Justin-Vuong/2024_WSB/README.md

WSB_Front
WSB_Back
