Justin-Vuong/2024_WSB/2024_WSB.pdf

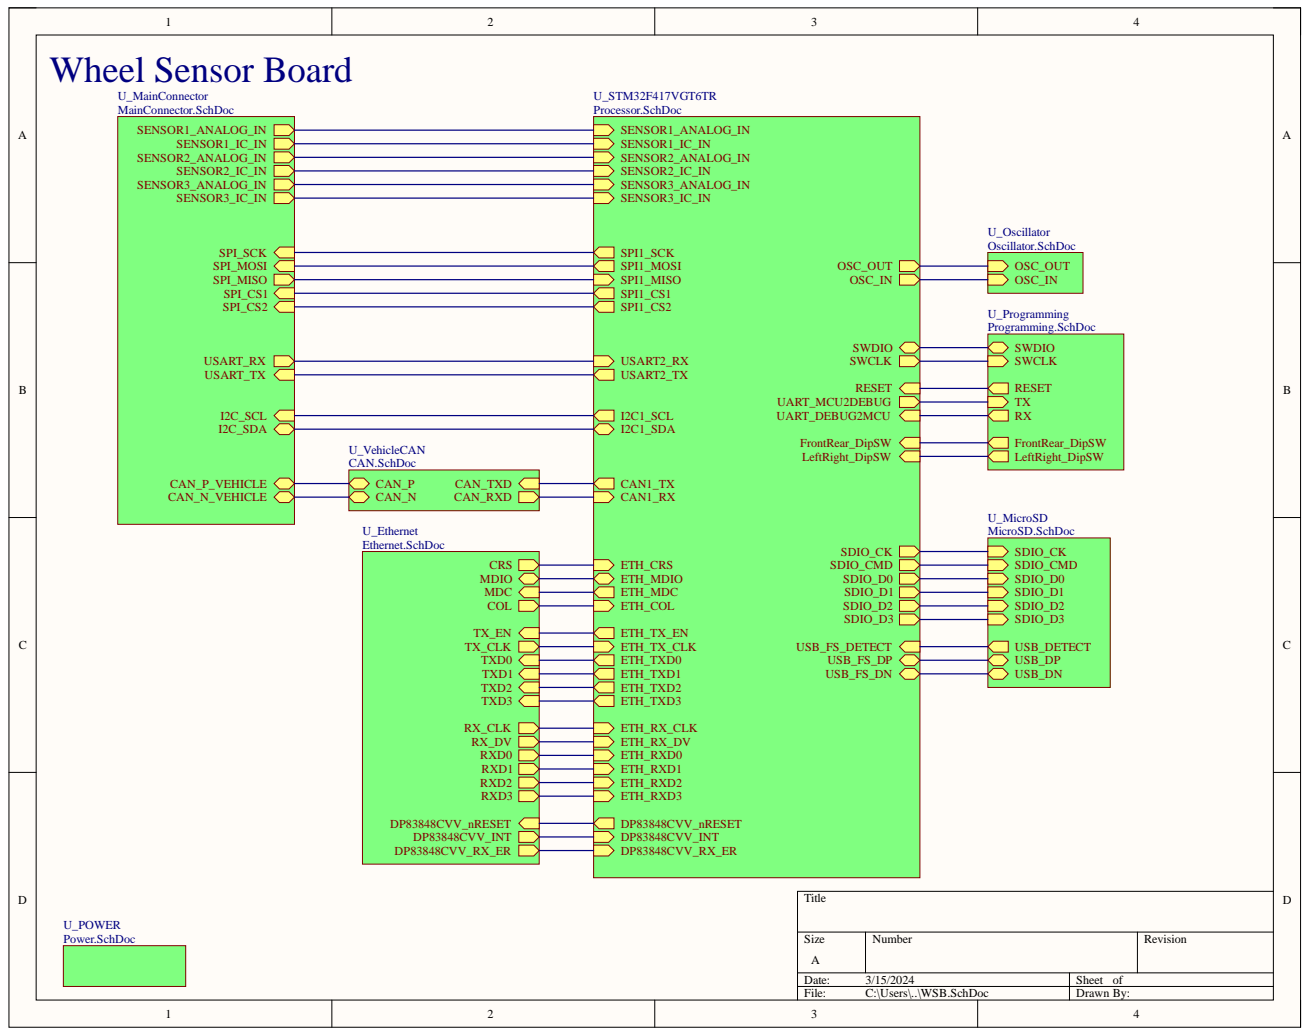
[picture p1: page 1]

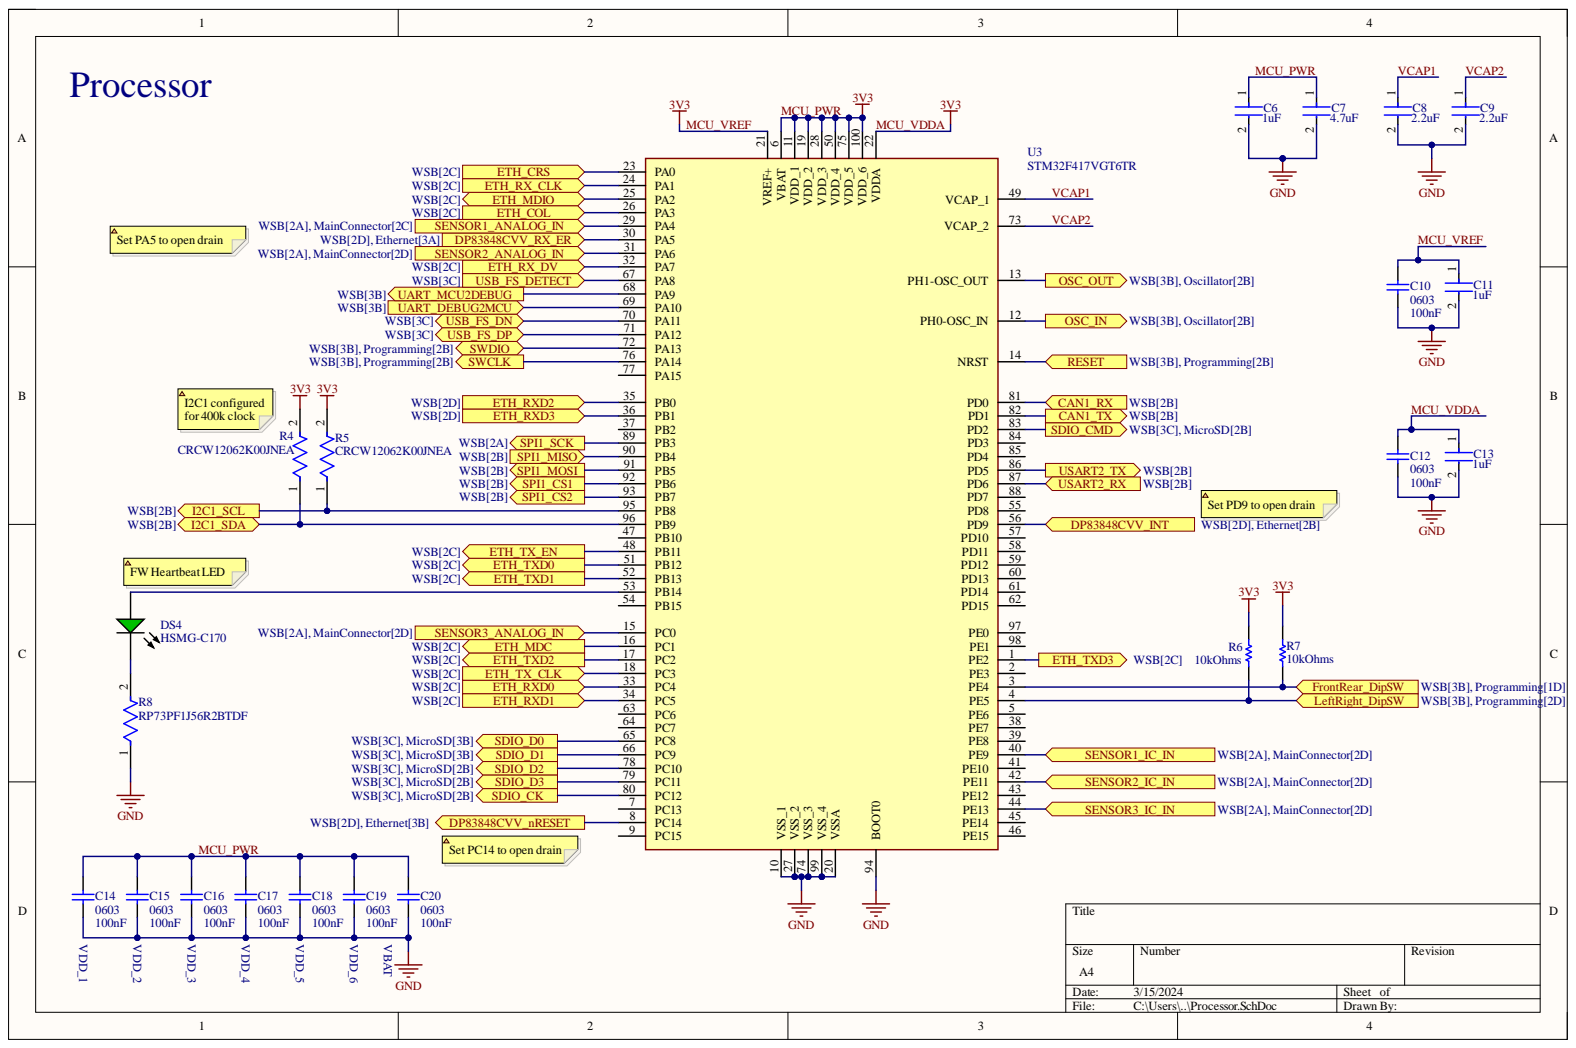
[picture p2: page 2]

Set PA5 to open drain

Set PD9 to open drain

Set PC14 to open drain

Size A4 | Number | Revision

Date: 3/15/2024 | Sheet of
File: C:\Users\..\Processor.SchDoc | Drawn By:

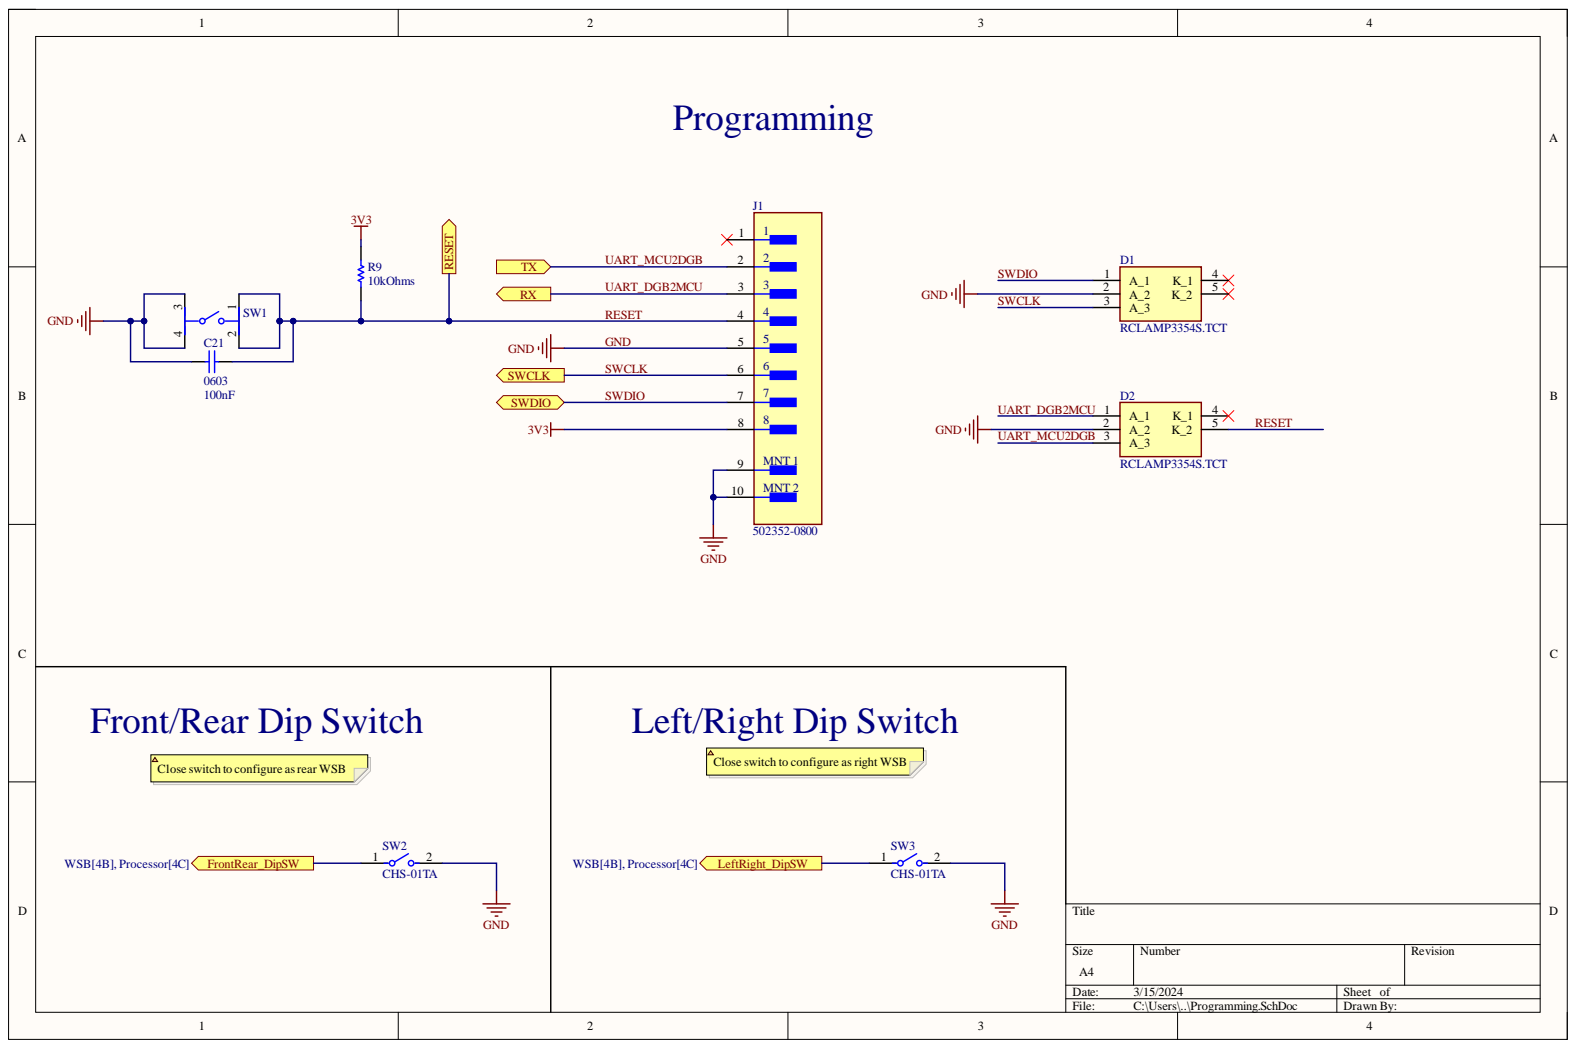
[picture p3: page 3]

Front/Rear Dip Switch Close switch to configure as rear WSB WSB[4B], Processor[4C] FrontRear_DipSW 1 2 SW2 | Left/Right Dip Switch Close switch to configure as right WSB 1 2 SW3

Size A4 | Number | Revision

Date: 3/15/2024 | Sheet of
File: C:\Users\..\Programming.SchDoc | Drawn By:

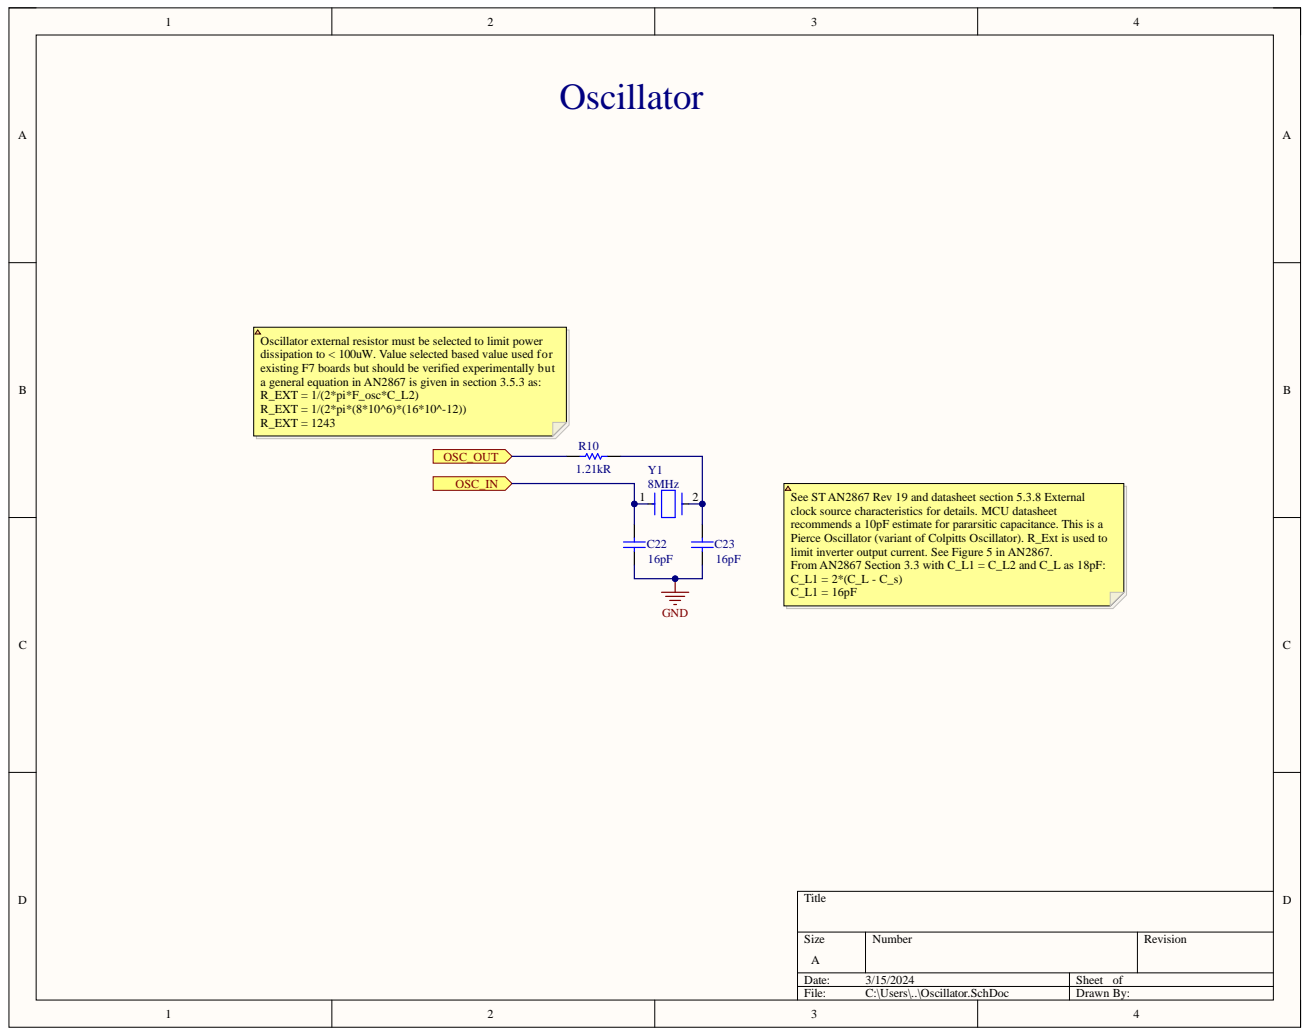
[picture p4: page 4]

Oscillator external resistor must be selected to limit power
dissipation to < 100uW. Value selected based value used for
existing F7 boards but should be verified experimentally but
a general equation in AN2867 is given in section 3.5.3 as:
R_EXT = 1/(2*pi*F_osc*C_L2)
R_EXT = 1/(2*pi*(8*10^6)*(16*10^-12))
R_EXT = 1243

See ST AN2867 Rev 19 and datasheet section 5.3.8 External
clock source characteristics for details. MCU datasheet
recommends a 10pF estimate for pararsitic capacitance. This is a
Pierce Oscillator (variant of Colpitts Oscillator). R_Ext is used to
limit inverter output current. See Figure 5 in AN2867.
From AN2867 Section 3.3 with C_L1 = C_L2 and C_L as 18pF:

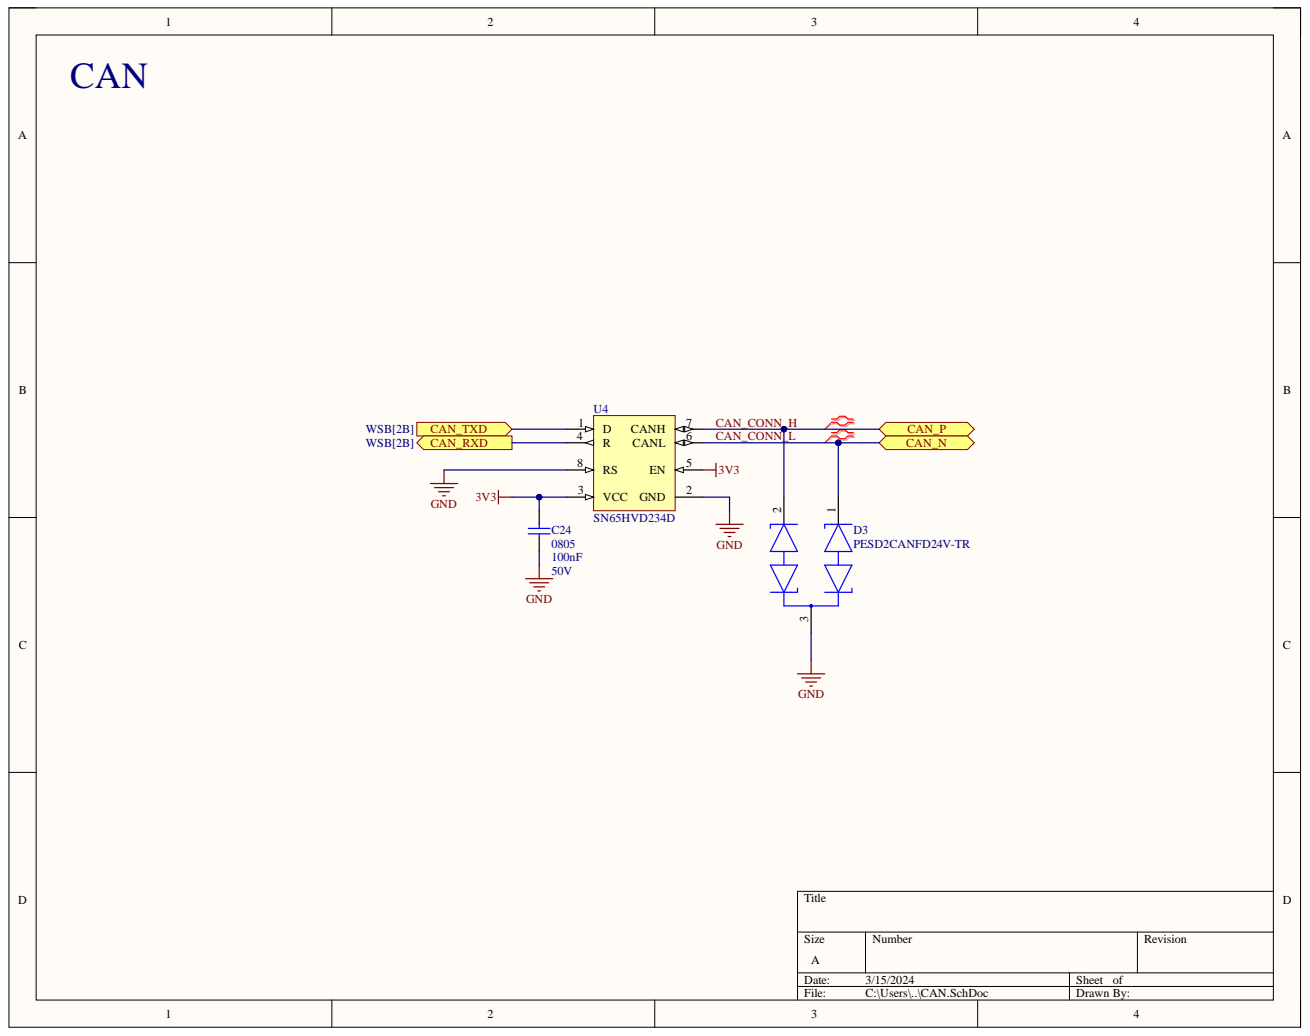
[picture p5: page 5]

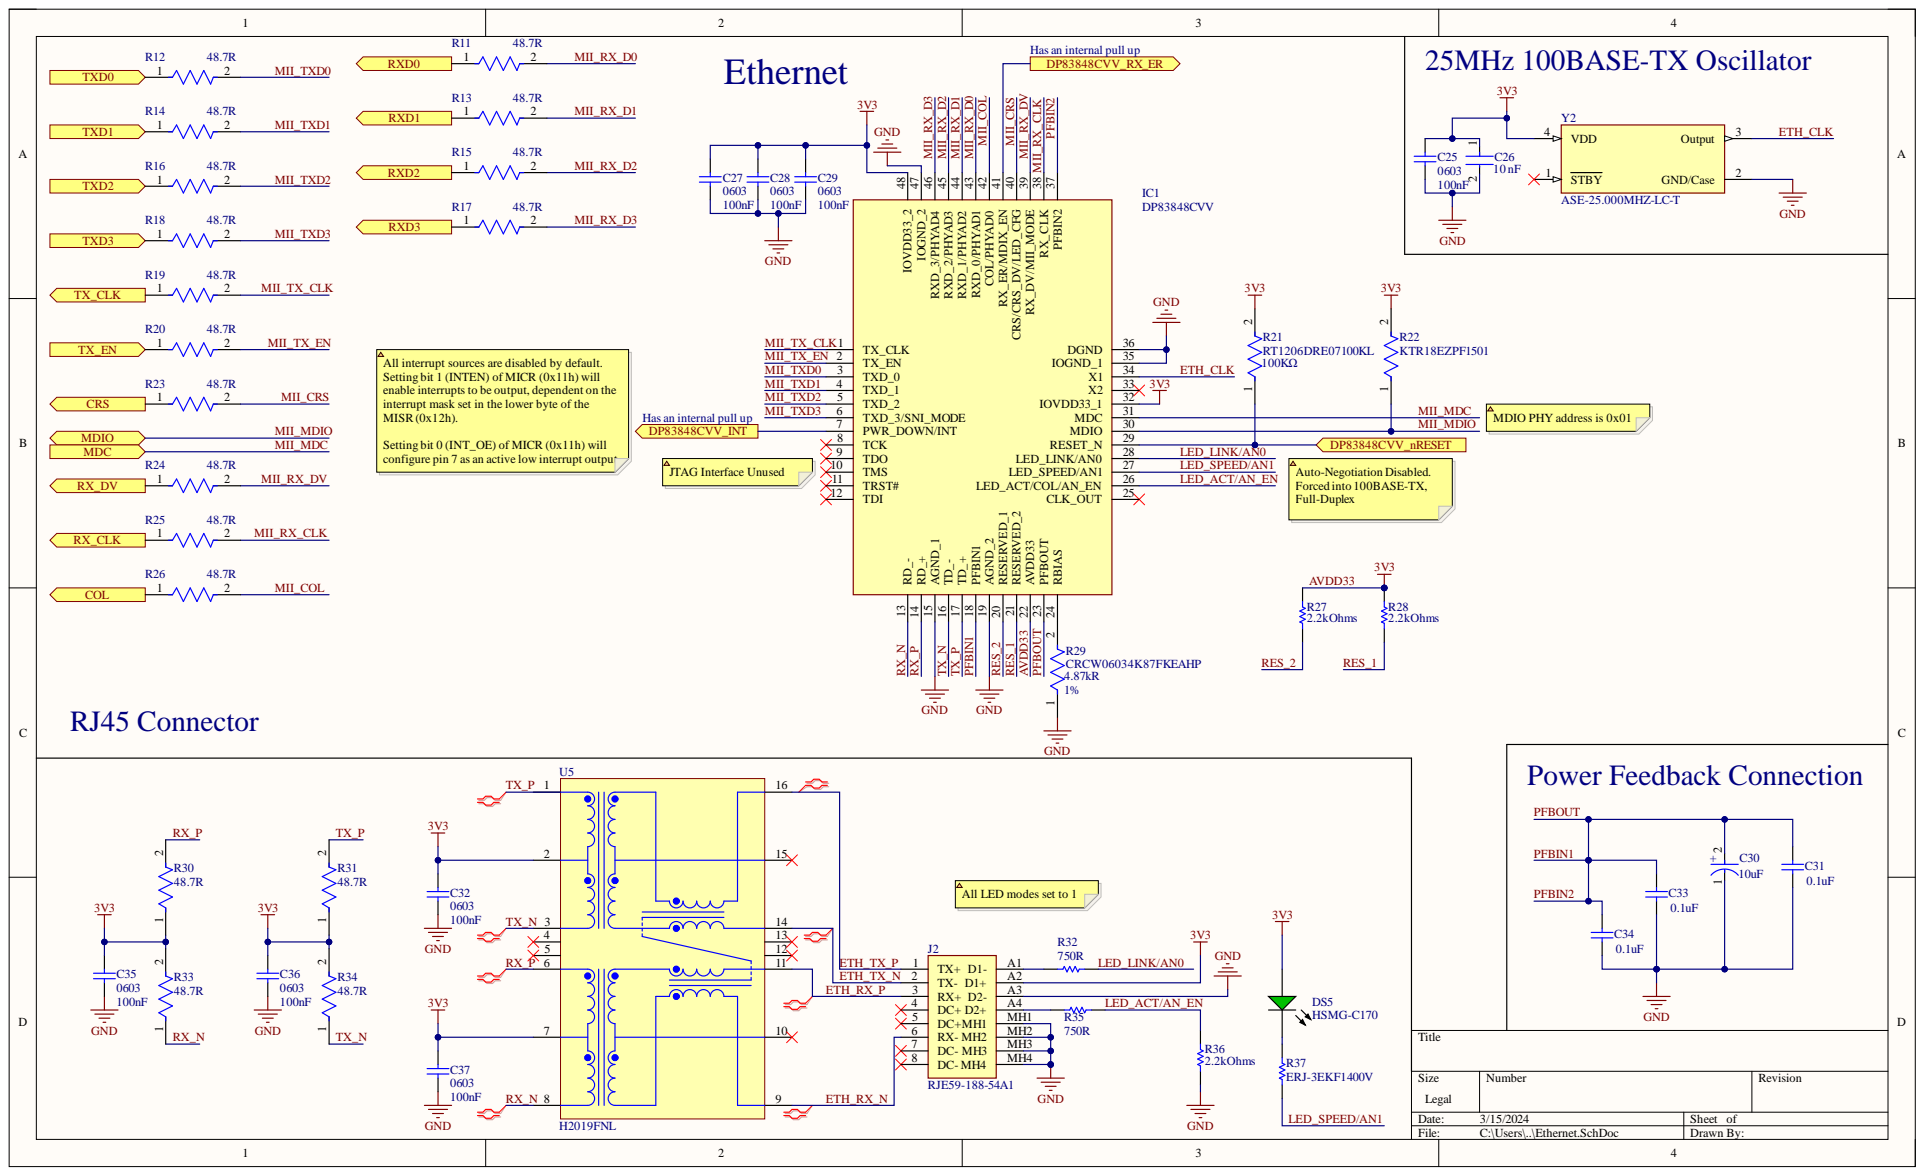
[picture p6: page 6]

Has an internal pull up | 25MHz 100BASE-TX Oscillator 3V3

All interrupt sources are disabled by default.
Setting bit 1 (INTEN) of MICR (0x11h) will
enable interrupts to be output, dependent on the
interrupt mask set in the lower byte of the
MISR (0x12h).

Has an internal pull up
DP83848CVV_INT

MDIO PHY address is 0x01

Setting bit 0 (INT_OE) of MICR (0x11h) will
configure pin 7 as an active low interrupt output

15 | ETH_TX_N

PFBIN1

All LED modes set to 1

ETH_RX_P | RX+ 3

DC+ 4 | LED_ACT/AN_EN

Size Legal | Number | Revision

Date: 3/15/2024 | Sheet of
File: C:\Users\..\Ethernet.SchDoc | Drawn By:

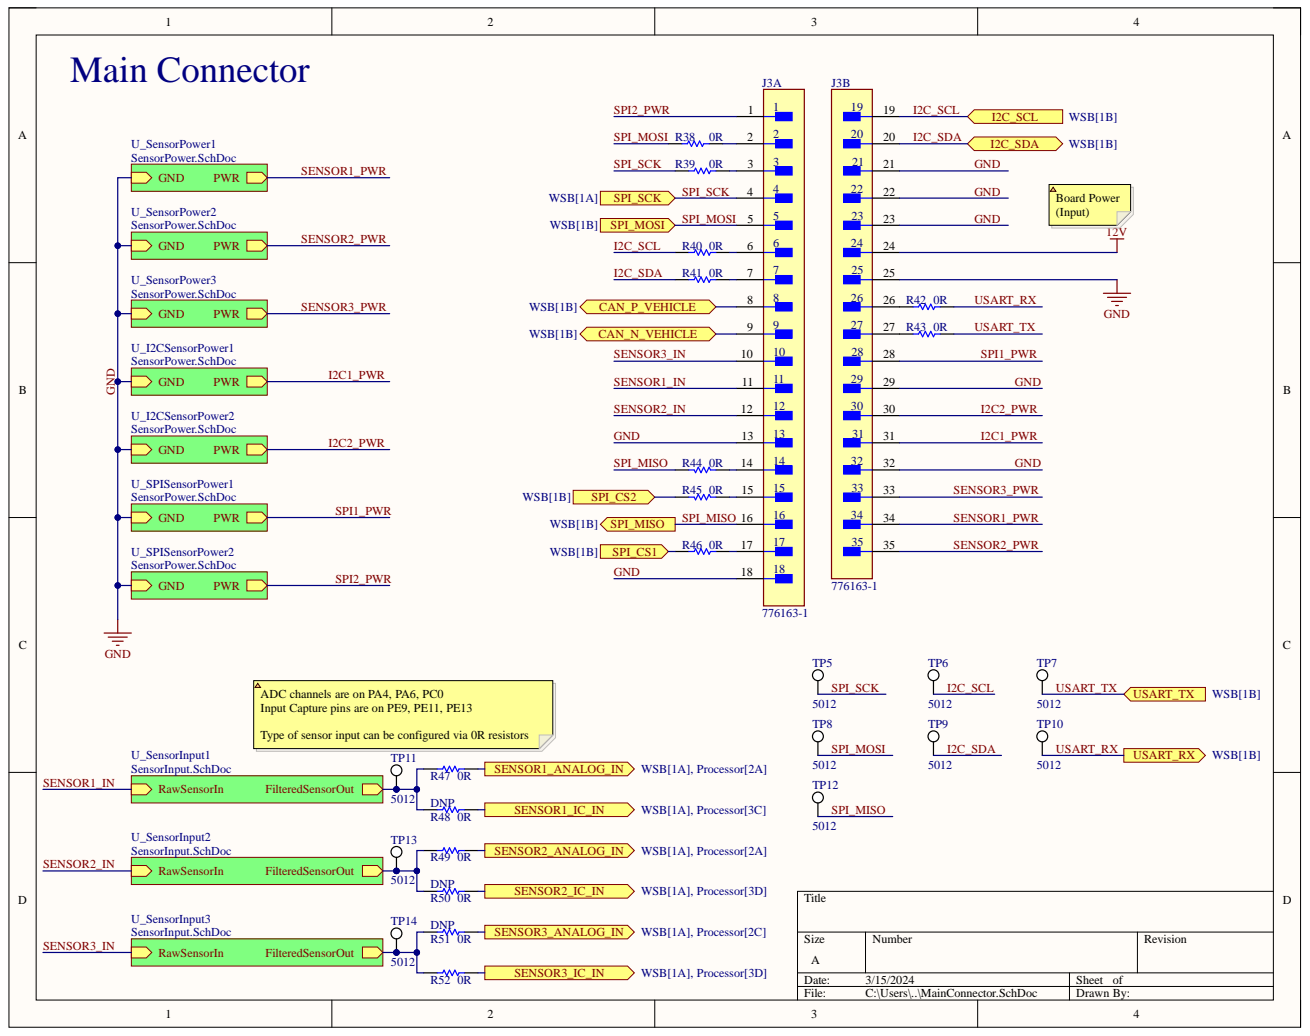
[picture p7: page 7]

ADC channels are on PA4, PA6, PC0
Input Capture pins are on PE9, PE11, PE13

Type of sensor input can be configured via 0R resistors

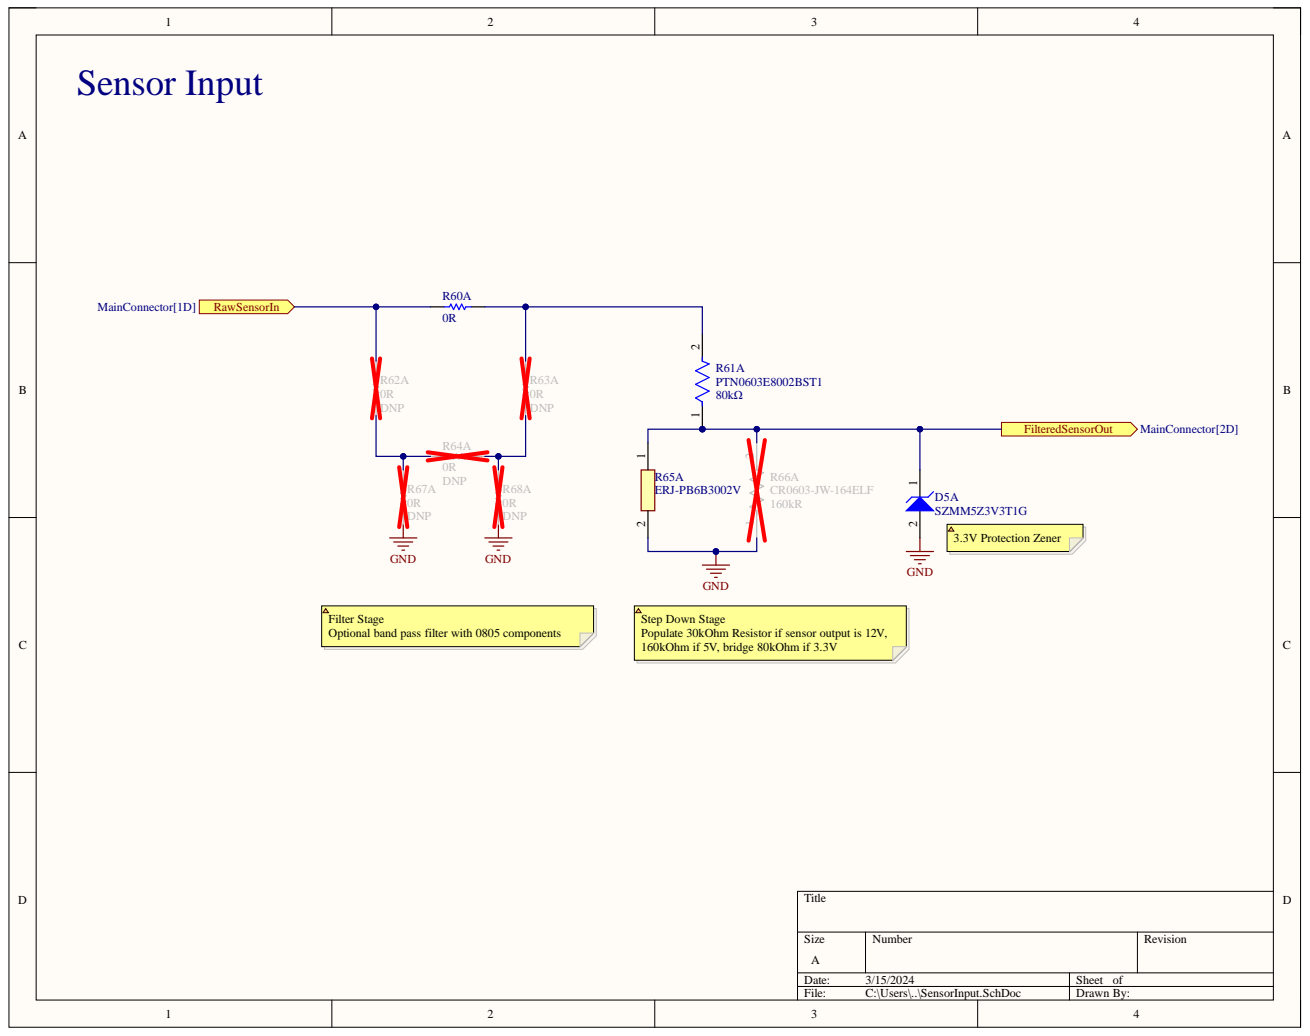
[picture p8: page 8]

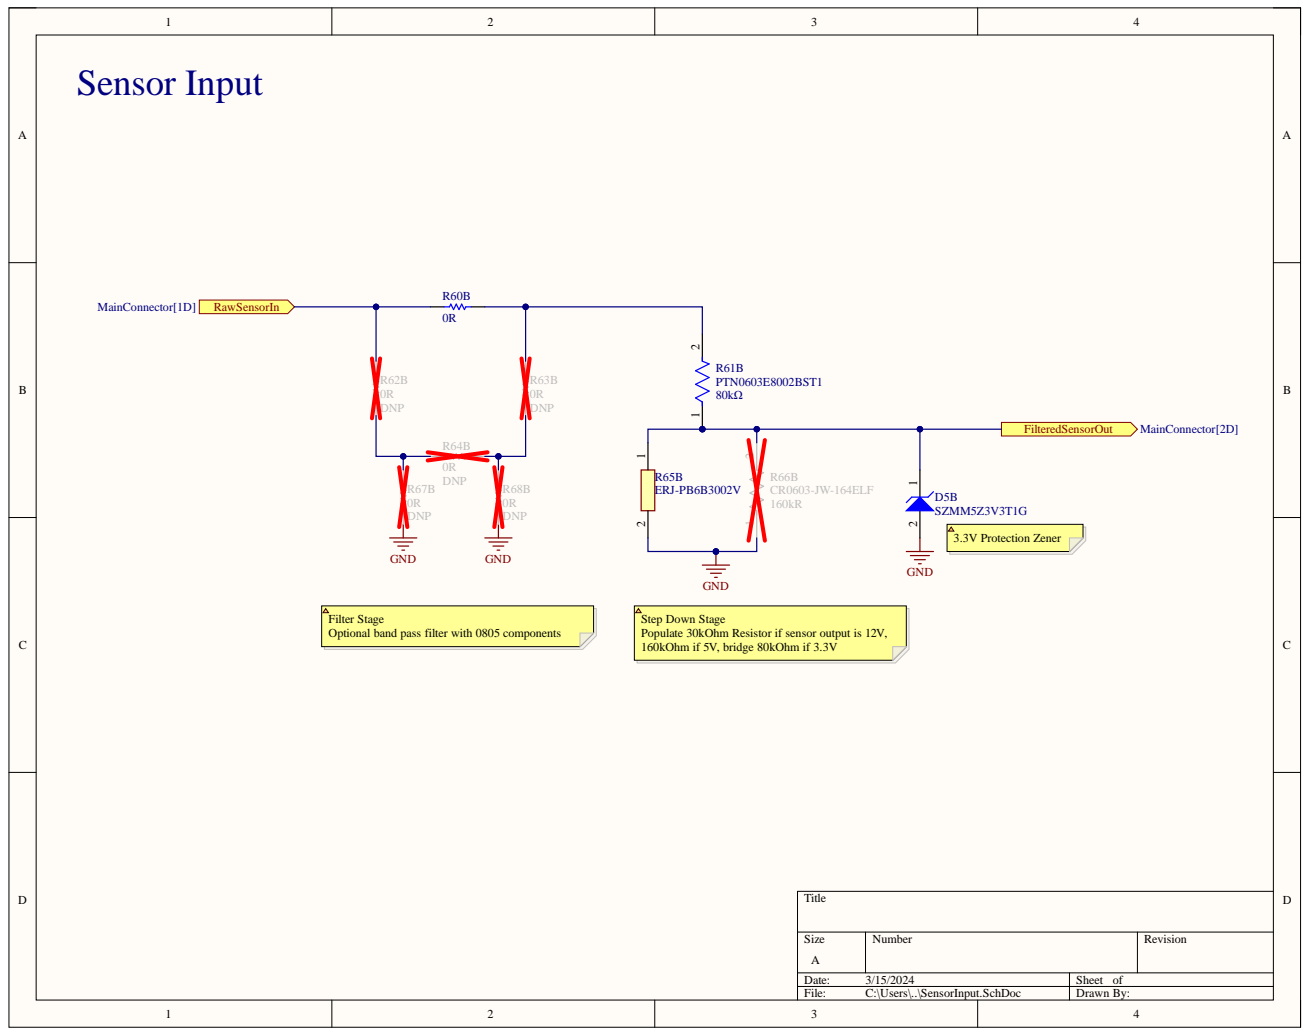
[picture p9: page 9]

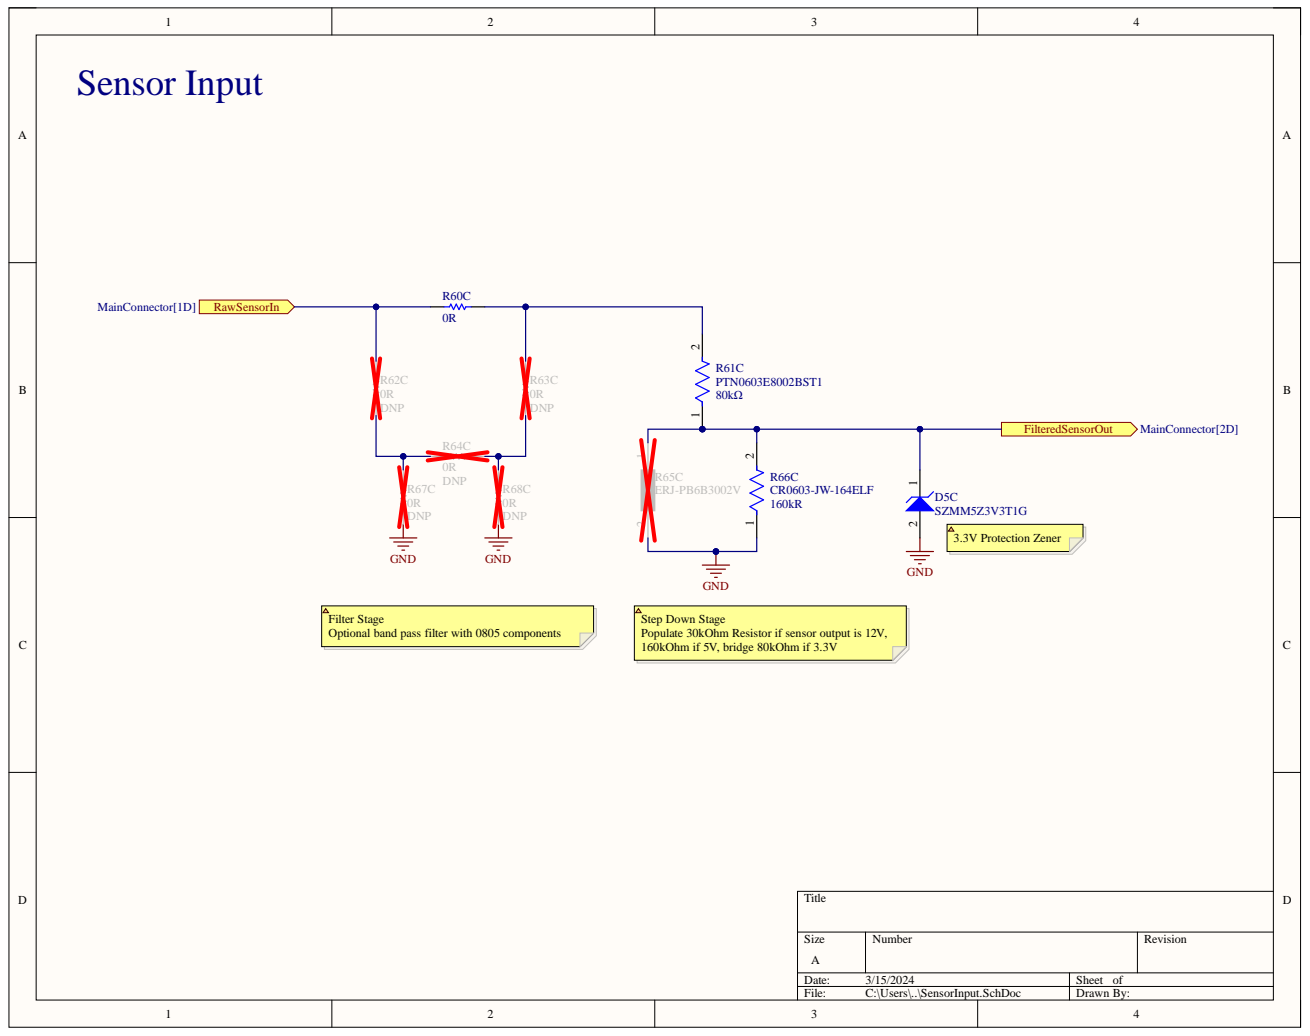
[picture p10: page 10]

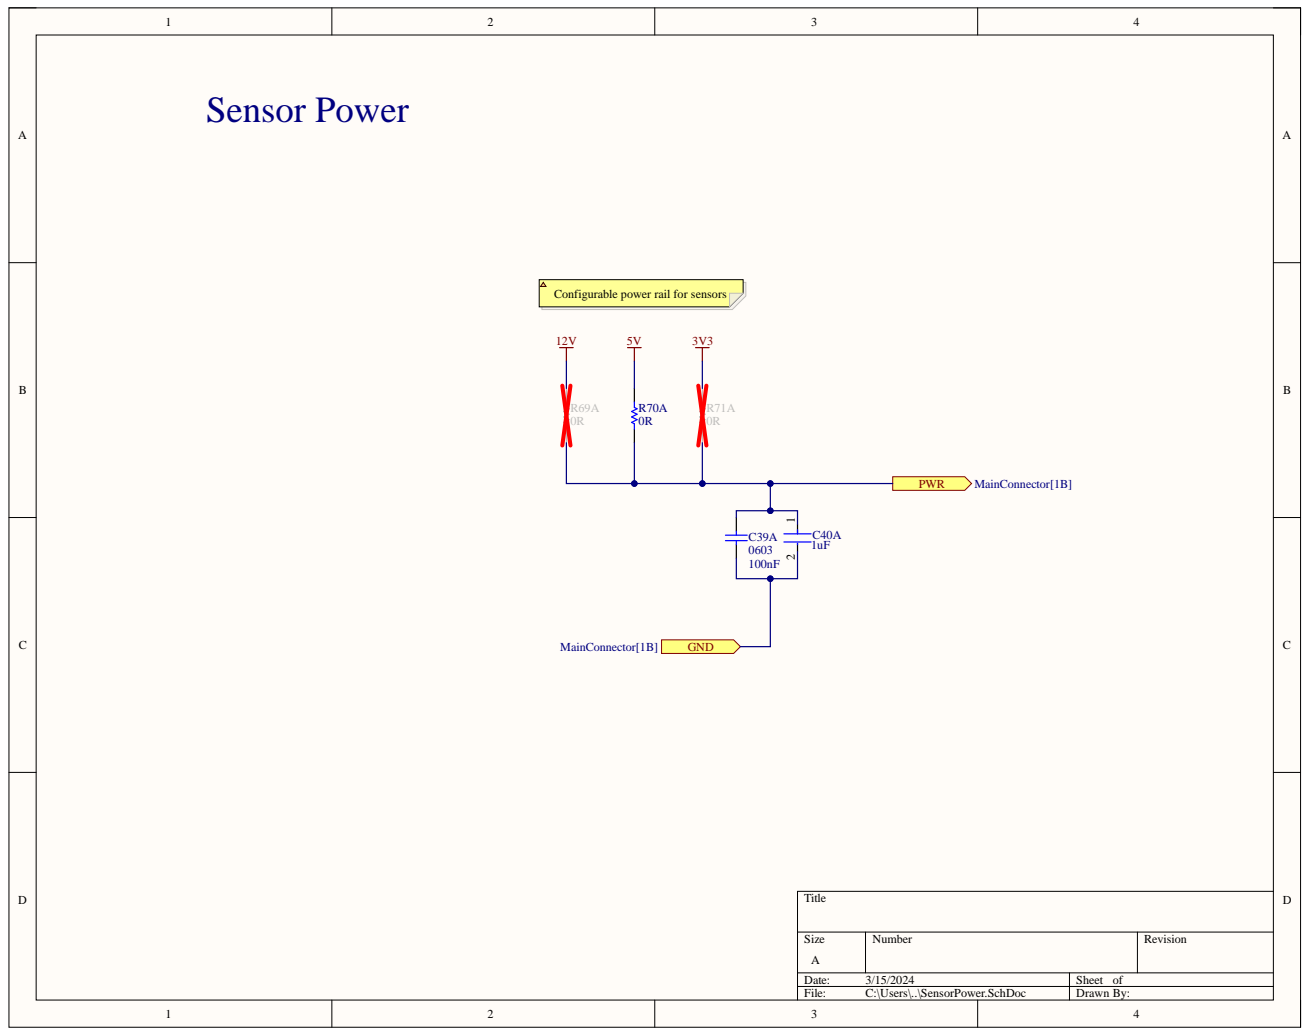
[picture p11: page 11]

Configurable power rail for sensors

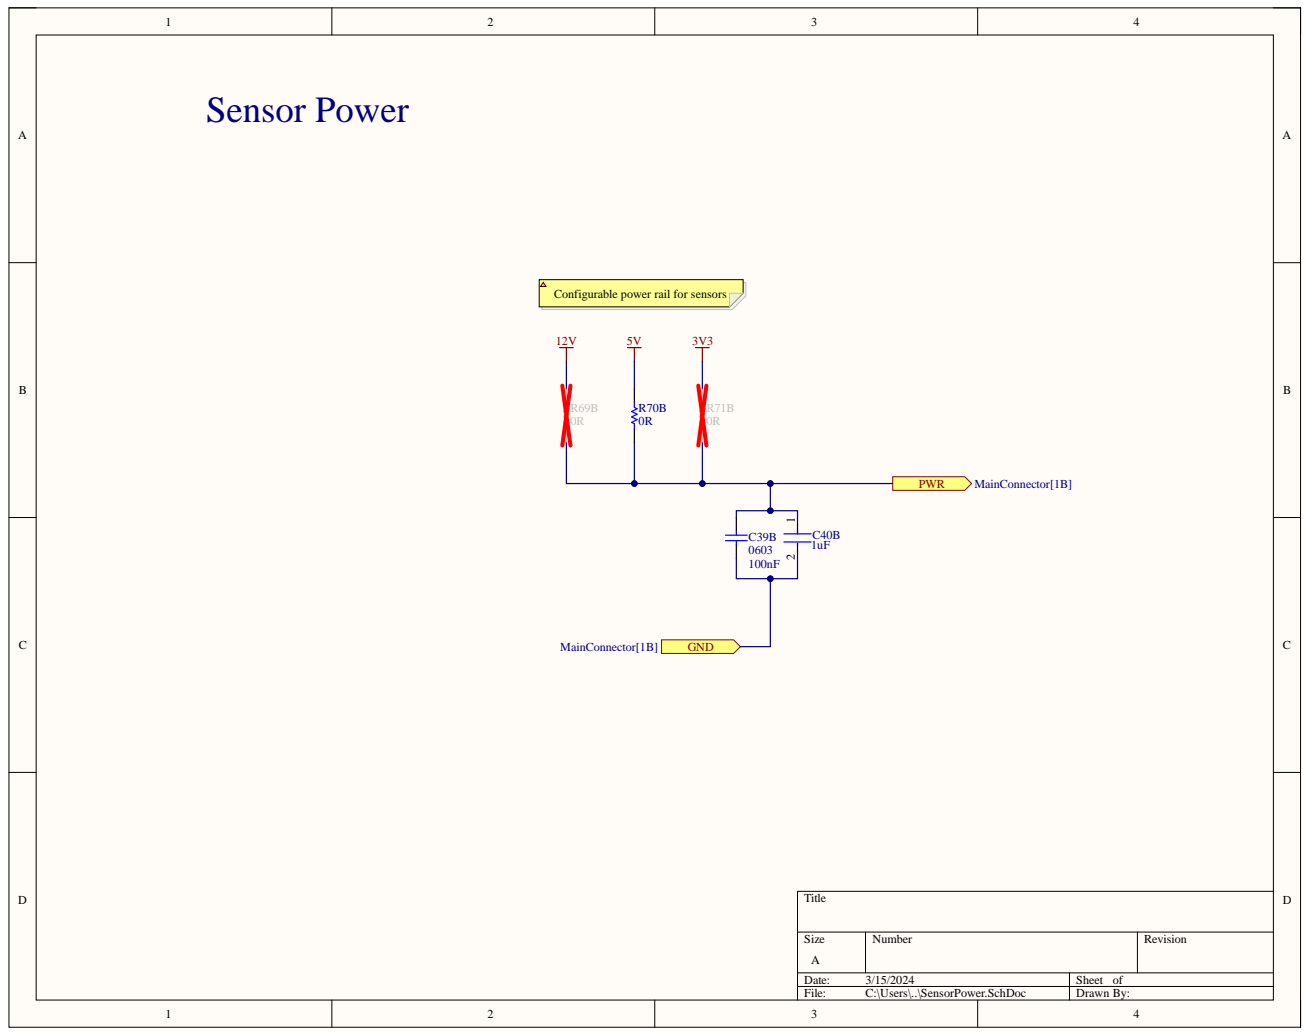
[picture p12: page 12]

Configurable power rail for sensors

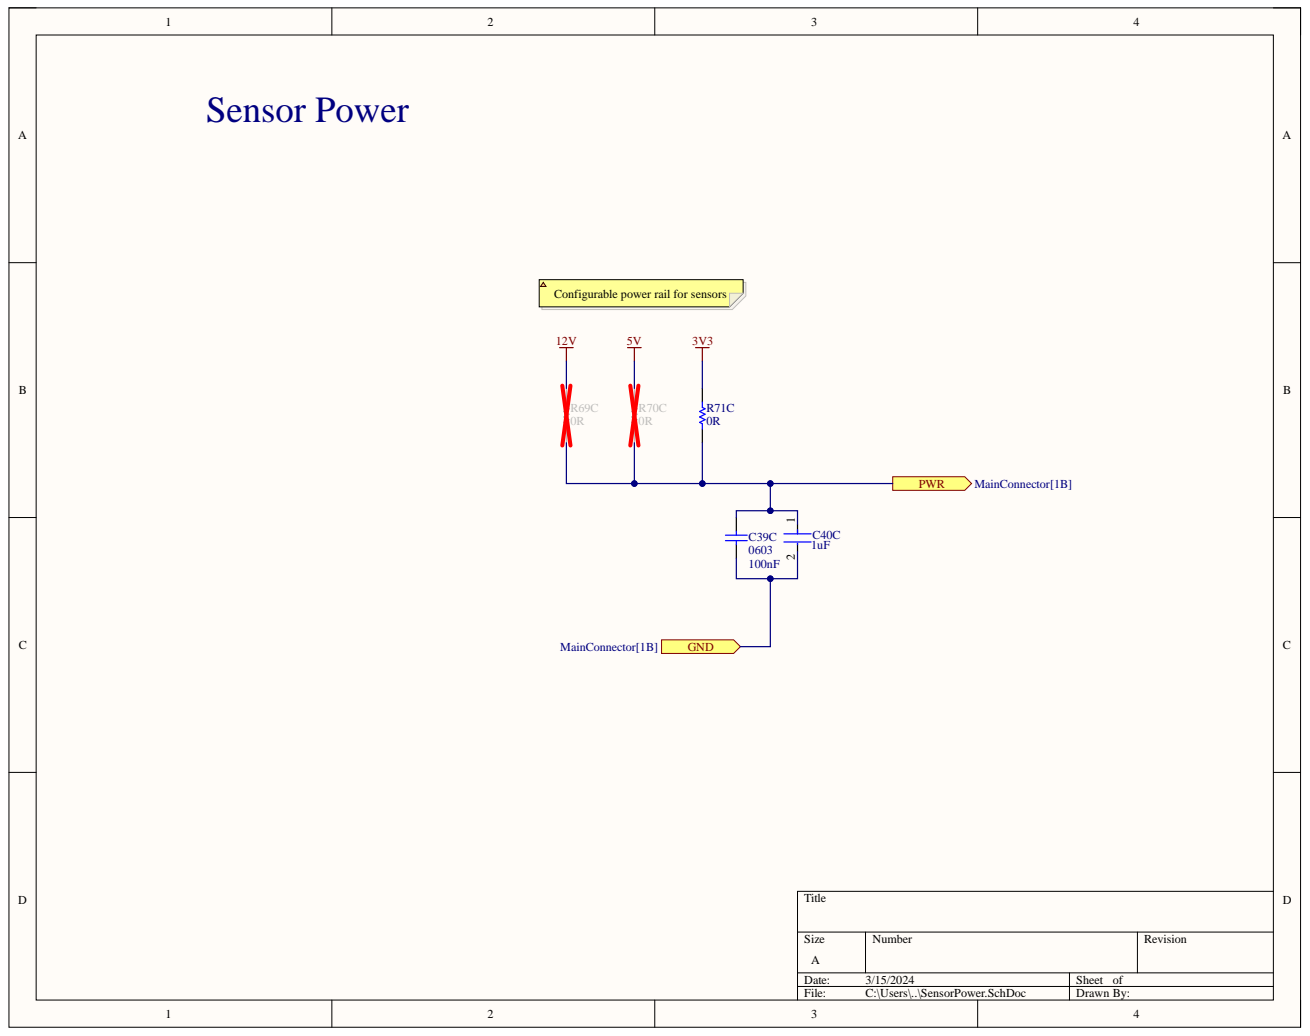
[picture p13: page 13]

Configurable power rail for sensors

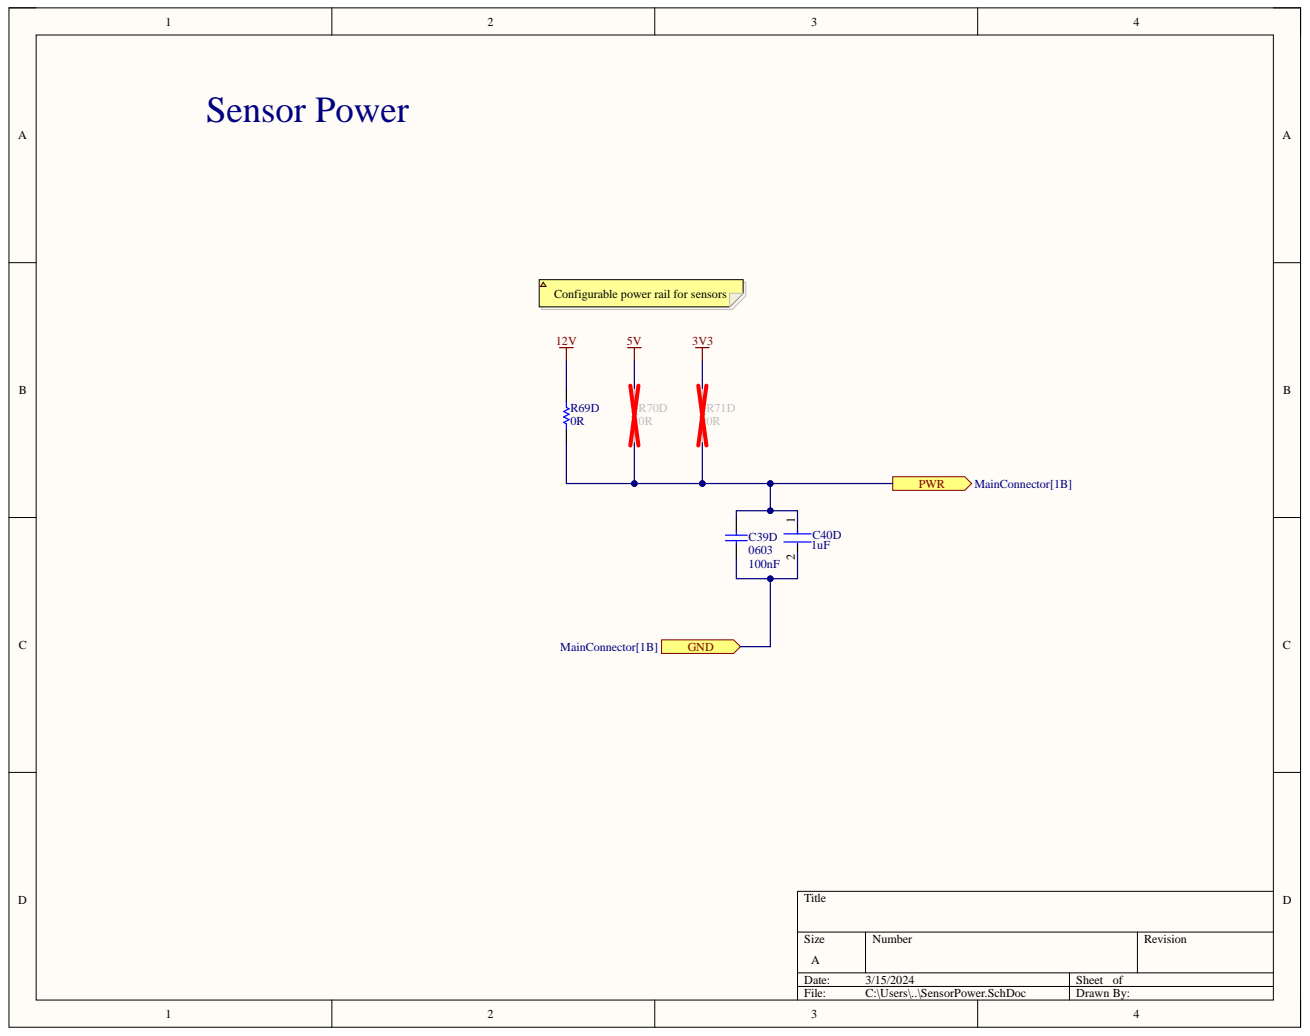
[picture p14: page 14]

Configurable power rail for sensors

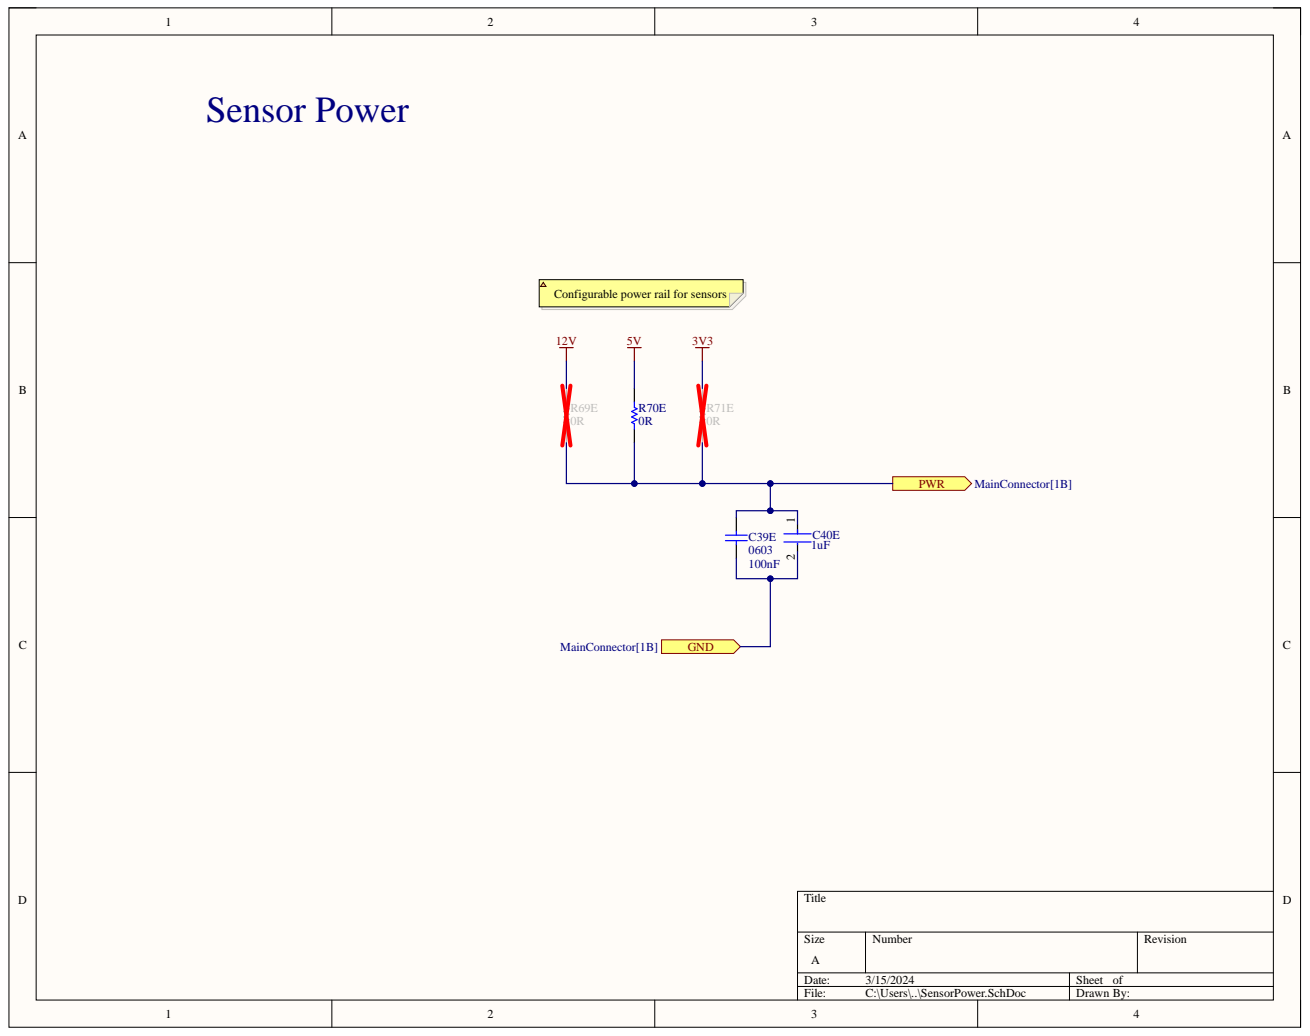
[picture p15: page 15]

Configurable power rail for sensors

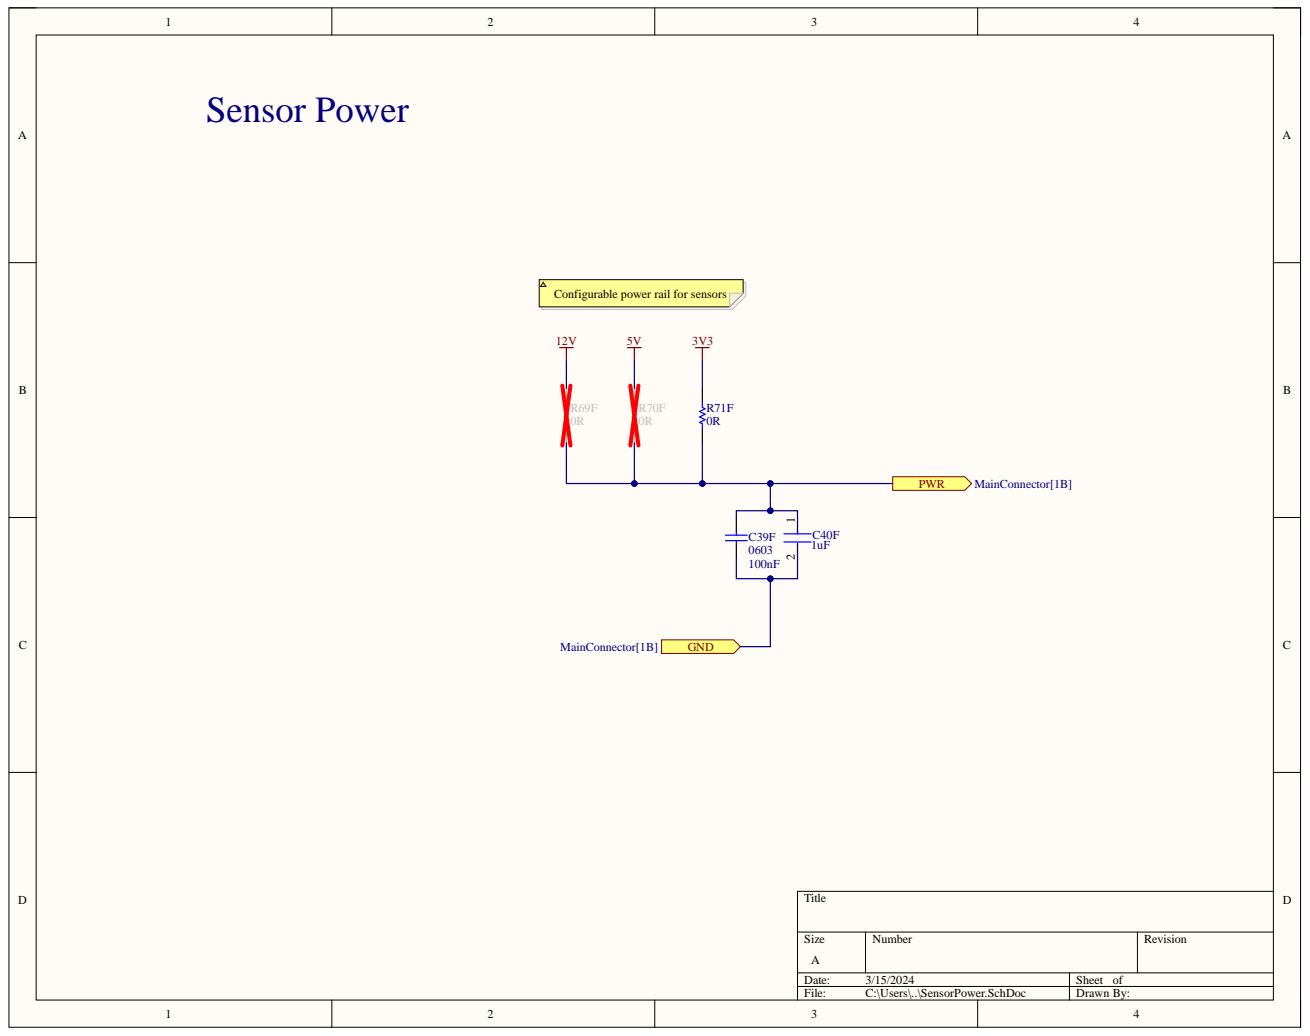
[picture p16: page 16]

Configurable power rail for sensors

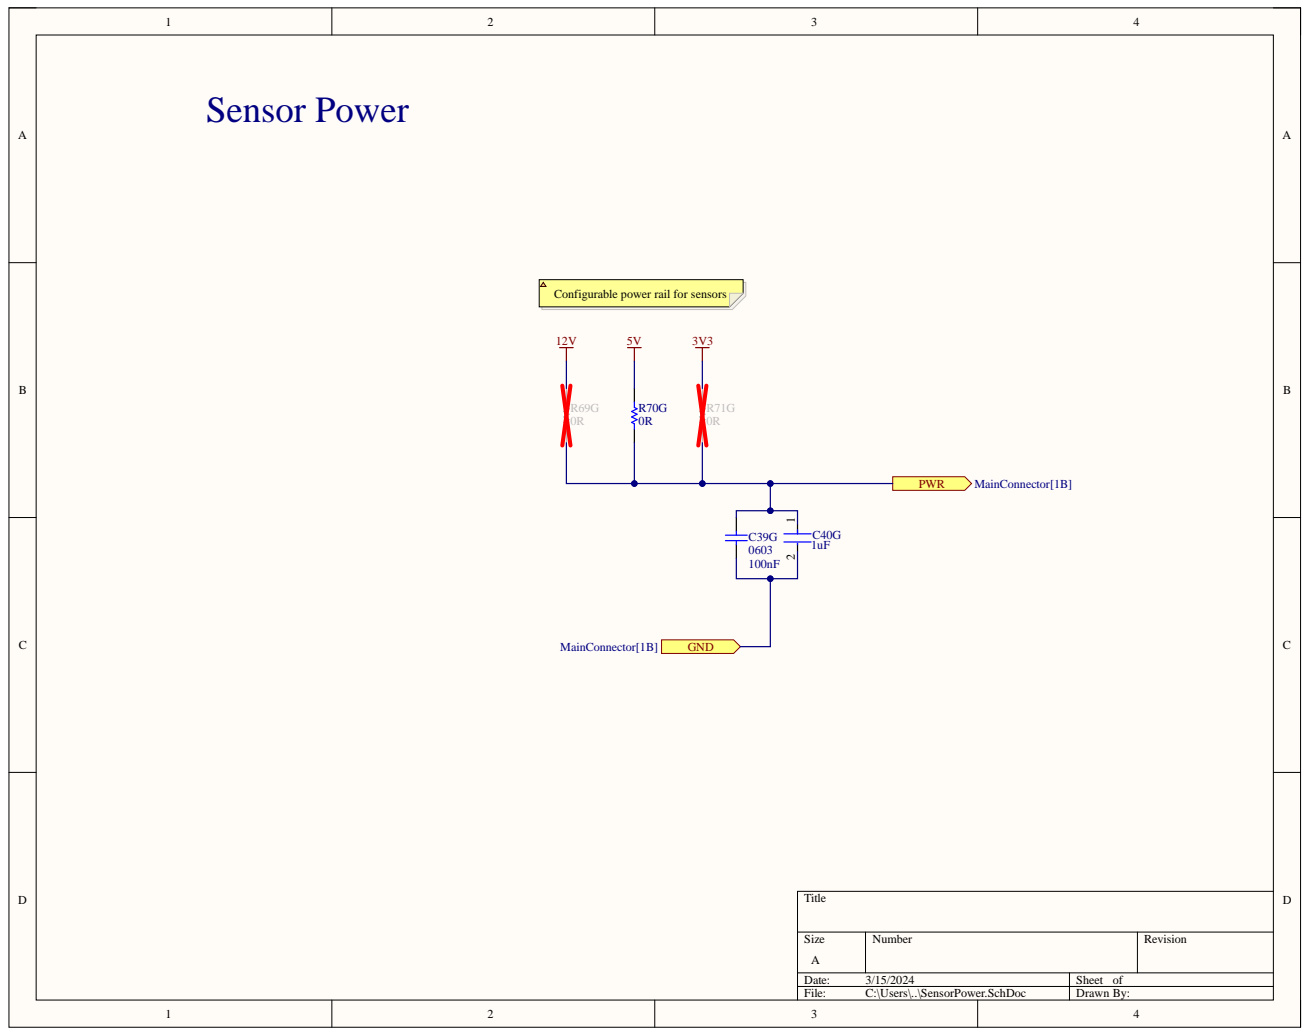
[picture p17: page 17]

Configurable power rail for sensors

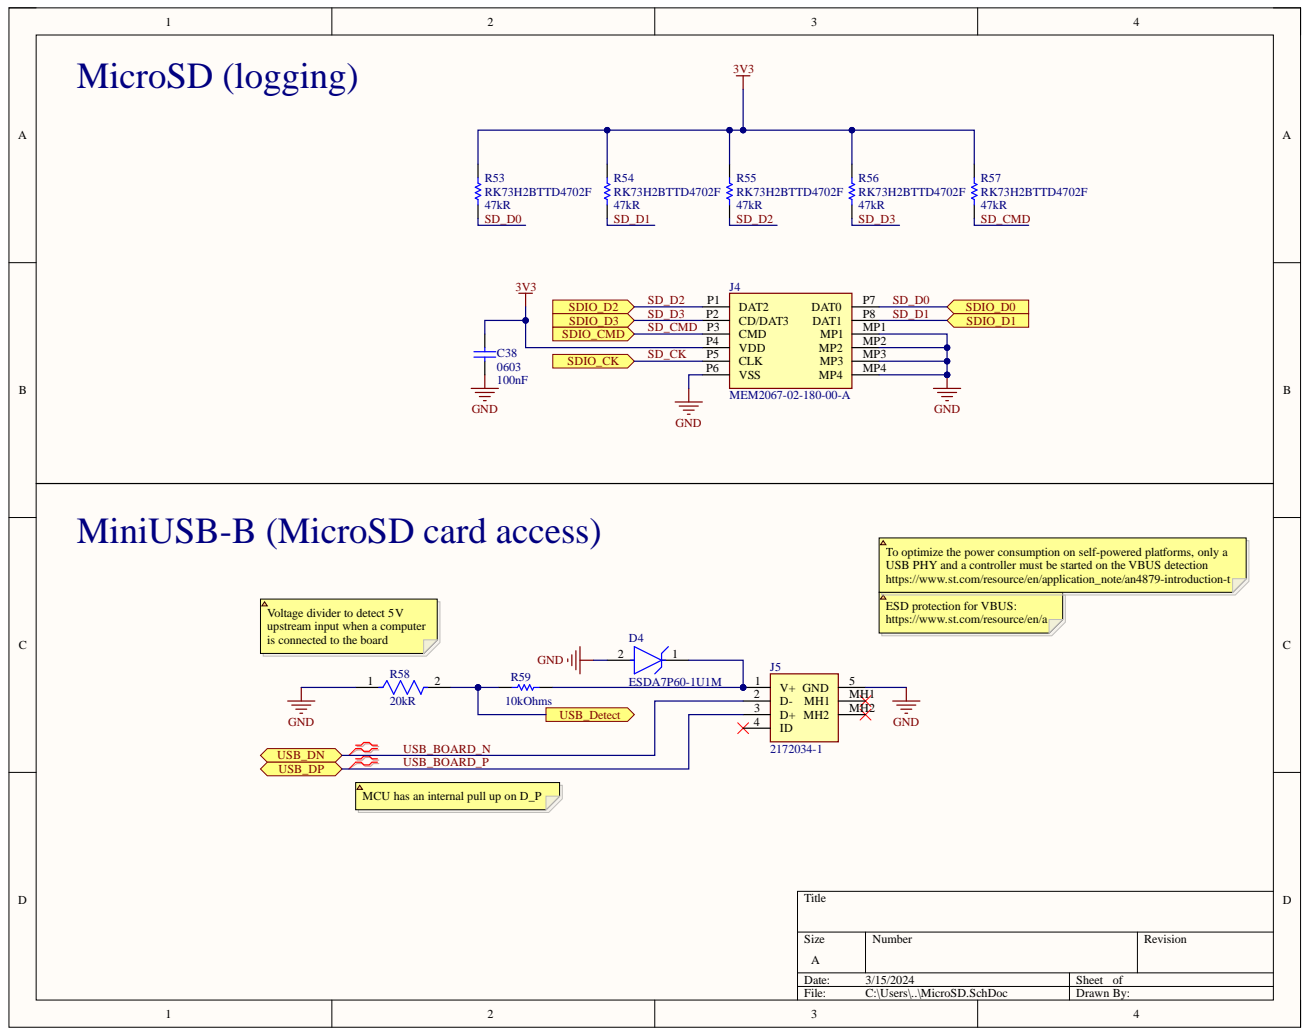
[picture p18: page 18]

MiniUSB-B (MicroSD card access)

To optimize the power consumption on self-powered platforms, only a
USB PHY and a controller must be started on the VBUS detection
https://www.st.com/resource/en/application_note/an4879-introduction-t

ESD protection for VBUS:
https://www.st.com/resource/en/a

Voltage divider to detect 5V
upstream input when a computer
is connected to the board

MCU has an internal pull up on D_P

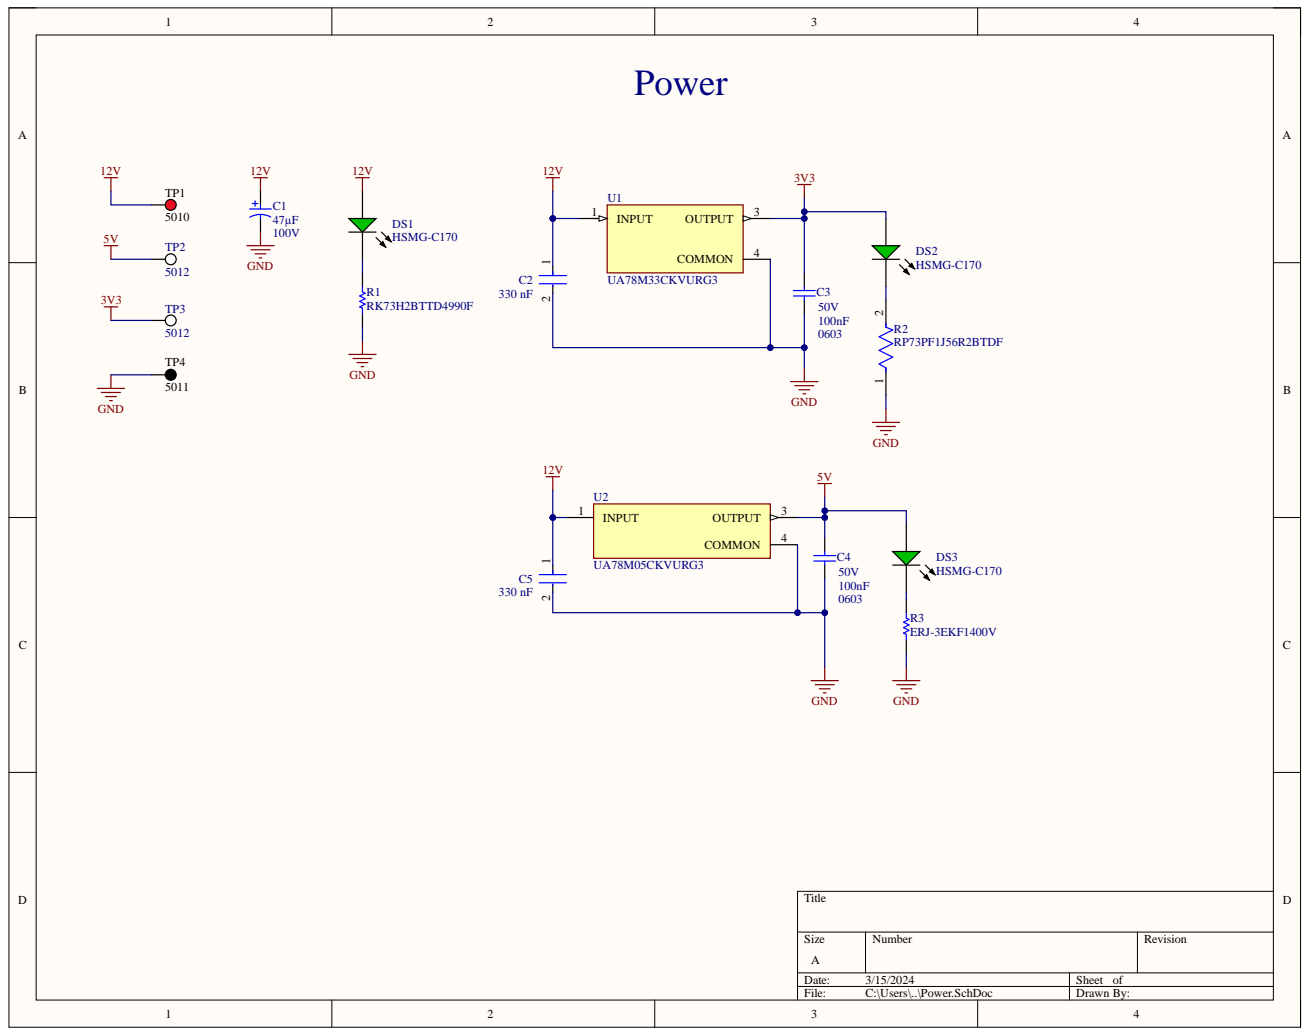
[picture p19: page 19]

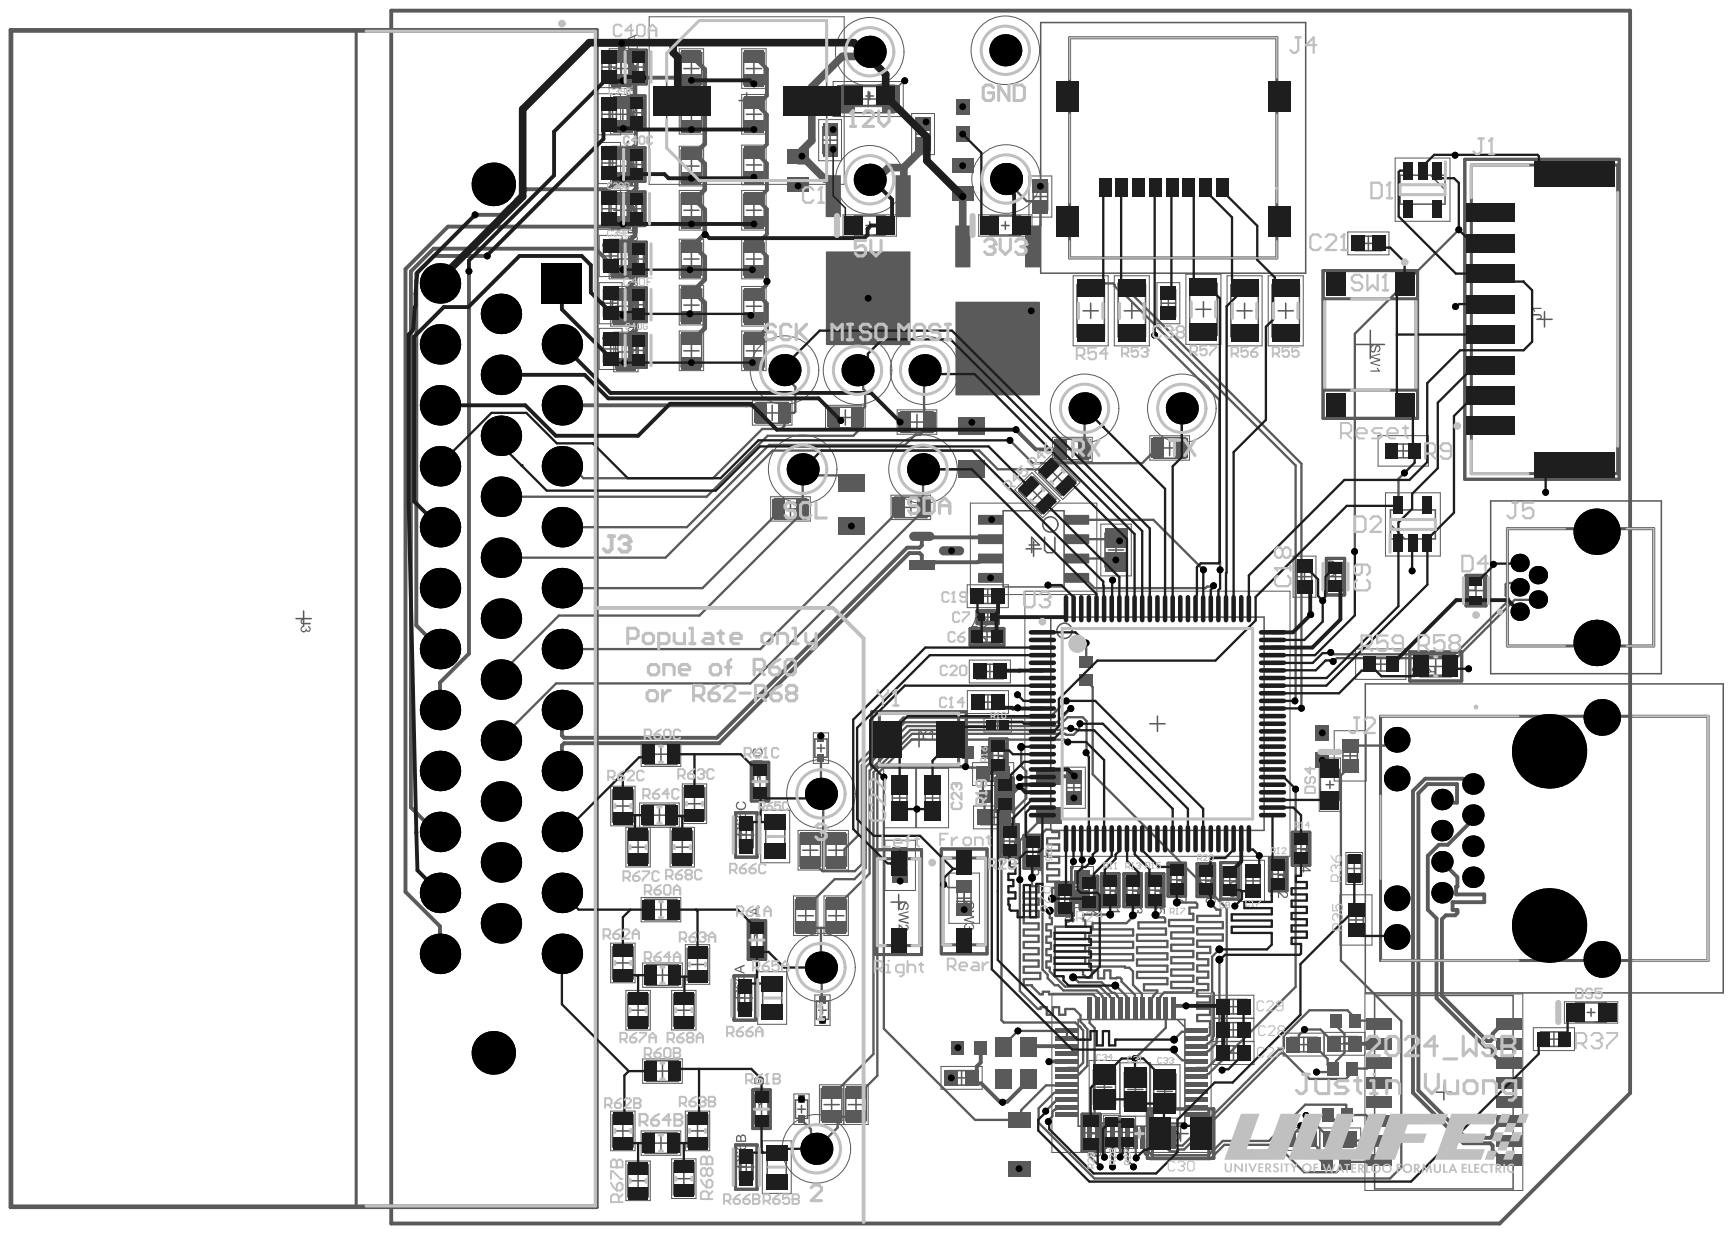
[picture p20: page 20]

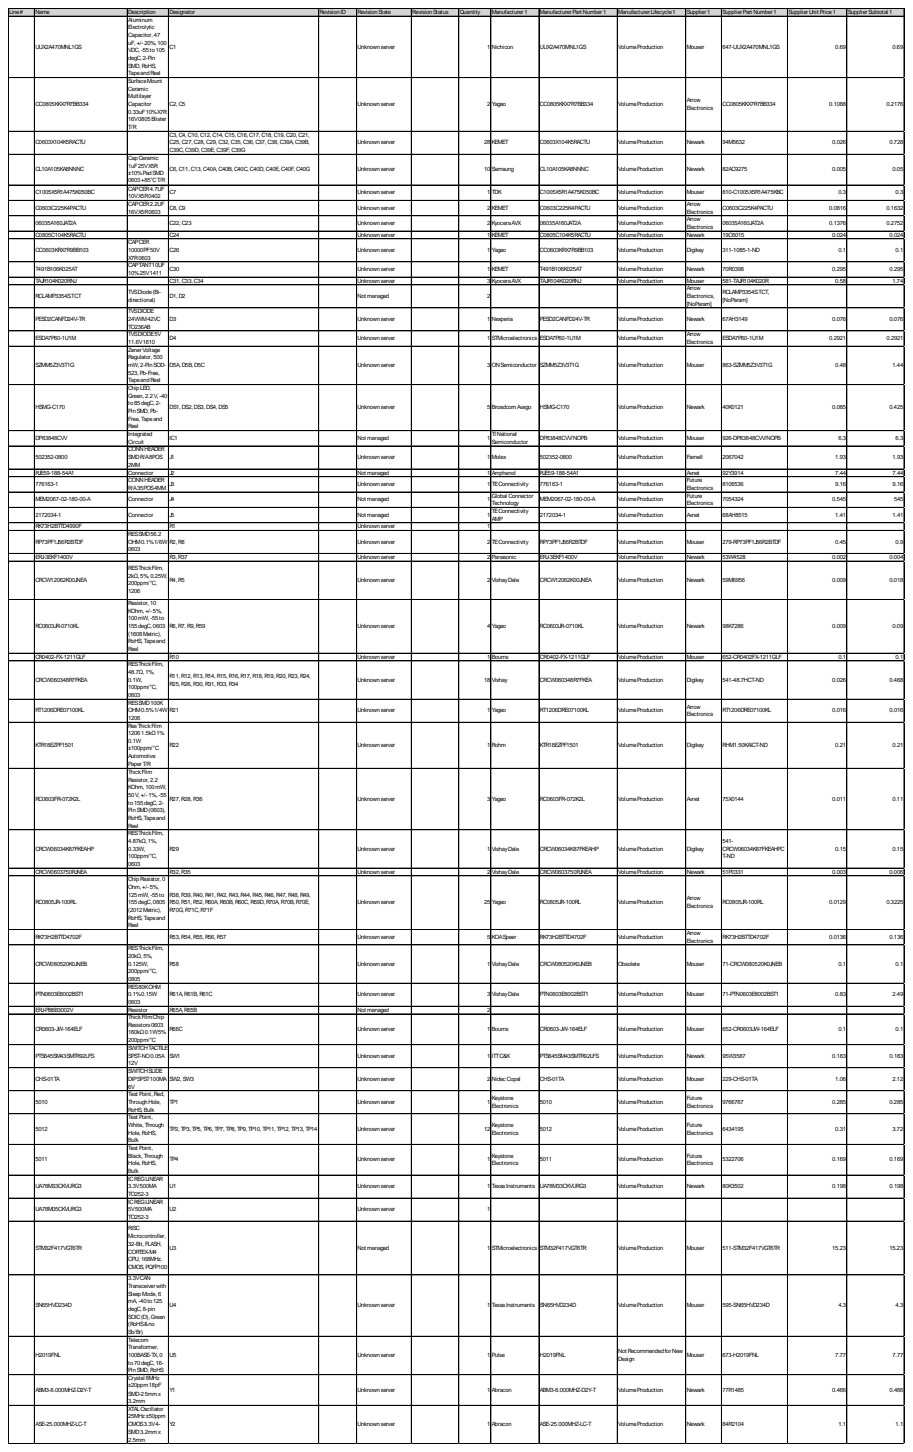
[picture p21: page 21]

CC0805KKX7R7BB334 | SurfaceMount Ceramic Multilayer Capacitor 0.33uF10%X7R 16V0805Blister T/R | C2, C5 | Unknownserver | | 2 Yageo | CC0805KKX7R7BB334 | VolumeProduction | Arrow Electronics | CC0805KKX7R7BB334 | 0.1088 | 0.2176

C0603X104K5RACTU | | C3, C4, C10, C12, C14, C15, C16, C17, C18, C19, C20, C21, C25, C27, C28, C29, C32, C35, C36, C37, C38, C39A, C39B, C39C, C39D, C39E, C39F, C39G | Unknownserver | 28 KEMET | | C0603X104K5RACTU | VolumeProduction | Newark | 94M5632 | 0.026 | 0.728

CL10A105KA8NNNC | CapCeramic 1uF25VX5R ±10%PadSMD 0603+85°CT/R | C6, C11, C13, C40A, C40B, C40C, C40D, C40E, C40F, C40G | Unknownserver | 10 Samsung | | CL10A105KA8NNNC | VolumeProduction | Newark | 82AC9275 | 0.005 | 0.05

C1005X5R1A475K050BC | CAPCER4.7UF 10VX5R0402 | C7 | Unknownserver | | 1 TDK | C1005X5R1A475K050BC | VolumeProduction | Mouser | 810-C1005X5R1A475KBC | 0.3 | 0.3

C0603C225K4PACTU | CAPCER2.2UF 16VX5R0603 | C8, C9 | Unknownserver | | 2 KEMET | C0603C225K4PACTU | VolumeProduction | Arrow Electronics | C0603C225K4PACTU | 0.0816 | 0.1632

06035A160JAT2A | | C22, C23 | Unknownserver | | 2 KyoceraAVX | 06035A160JAT2A | VolumeProduction | Arrow Electronics | 06035A160JAT2A | 0.1376 | 0.2752

C0805C104K5RACTU | | C24 | Unknownserver | | 1 KEMET | C0805C104K5RACTU | VolumeProduction | Newark | 19C6015 | 0.024 | 0.024
CC0603KRX7R9BB103 | CAPCER 10000PF50V X7R0603 | C26 | Unknownserver | | 1 Yageo | CC0603KRX7R9BB103 | VolumeProduction | Digikey | 311-1085-1-ND | 0.1 | 0.1

T491B106K025AT | CAPTANT10UF 10%25V1411 | C30 | Unknownserver | | 1 KEMET | T491B106K025AT | VolumeProduction | Newark | 70R0398 | 0.295 | 0.295

TAJR104K020RNJ | | C31, C33, C34 | Unknownserver | | 3 KyoceraAVX | TAJR104K020RNJ | VolumeProduction | Mouser | 581-TAJR104K020R | 0.58 | 1.74
RCLAMP3354S.TCT | TVSDiode(Bi-directional) | D1, D2 | Not managed | | 2 | | | Arrow Electronics, [NoParam] | RCLAMP3354S.TCT, [NoParam]

PESD2CANFD24V-TR | TVSDIODE 24VWM42VC TO236AB | D3 | Unknownserver | | 1 Nexperia | PESD2CANFD24V-TR | VolumeProduction | Newark | 67AH3149 | 0.076 | 0.076

ESDA7P60-1U1M | TVSDIODE5V 11.6V1610 | D4 | Unknownserver | | 1 STMicroelectronics | ESDA7P60-1U1M | VolumeProduction | Arrow Electronics | ESDA7P60-1U1M | 0.2921 | 0.2921

SZMM5Z3V3T1G | ZenerVoltage Regulator, 500 mW, 2-PinSOD-523, Pb-Free, TapeandReel | D5A, D5B, D5C | Unknownserver | | 3 ONSemiconductor | SZMM5Z3V3T1G | VolumeProduction | Mouser | 863-SZMM5Z3V3T1G | 0.48 | 1.44

HSMG-C170 | ChipLED, Green, 2.2V, -40 to85degC, 2-PinSMD, Pb-Free, Tapeand Reel | DS1, DS2, DS3, DS4, DS5 | Unknownserver | | 5 BroadcomAvago | HSMG-C170 | VolumeProduction | Newark | 40K0121 | 0.085 | 0.425

DP83848CVV | Integrated Circuit | IC1 | Not managed | | 1 TINational Semiconductor | DP83848CVV/NOPB | VolumeProduction | Mouser | 926-DP83848CVV/NOPB | 6.3 | 6.3

502352-0800 | CONNHEADER SMDR/A8POS 2MM | J1 | Unknownserver | | 1 Molex | 502352-0800 | VolumeProduction | Farnell | 2067042 | 1.93 | 1.93

RJE59-188-54A1 | Connector | J2 | Not managed | | 1 Amphenol | RJE59-188-54A1 | | Avnet | 92Y3914 | 7.44 | 7.44
776163-1 | CONNHEADER R/A35POS4MM | J3 | Unknownserver | | 1 TEConnectivity | 776163-1 | VolumeProduction | Future Electronics | 8106536 | 9.16 | 9.16

MEM2067-02-180-00-A | Connector | J4 | Not managed | | 1 Global Connector Technology | MEM2067-02-180-00-A | VolumeProduction | Future Electronics | 7054324 | 0.545 | 545

2172034-1 | Connector | J5 | Not managed | | 1 TEConnectivity AMP | 2172034-1 | VolumeProduction | Avnet | 68AH8515 | 1.41 | 1.41

RK73H2BTTD4990F | | R1 | Unknownserver | | 1
RP73PF1J56R2BTDF | RESSMD56.2 OHM0.1%1/6W 0603 | R2, R8 | Unknownserver | | 2 TEConnectivity | RP73PF1J56R2BTDF | VolumeProduction | Mouser | 279-RP73PF1J56R2BTDF | 0.45 | 0.9

ERJ-3EKF1400V | | R3, R37 | Unknownserver | | 2 Panasonic | ERJ-3EKF1400V | VolumeProduction | Newark | 53W4528 | 0.002 | 0.004

CRCW12062K00JNEA | RESThickFilm, 2kΩ, 5%, 0.25W, 200ppm/°C, 1206 | R4, R5 | Unknownserver | | 2 VishayDale | CRCW12062K00JNEA | VolumeProduction | Newark | 59M6956 | 0.009 | 0.018

RC0603JR-0710KL | Resistor, 10 KOhm, +/- 5%, 100mW, -55to 155degC, 0603 (1608Metric), RoHS, Tapeand Reel | R6, R7, R9, R59 | Unknownserver | | 4 Yageo | RC0603JR-0710KL | VolumeProduction | Newark | 98K7286 | 0.009 | 0.09

CR0402-FX-1211GLF | | R10 | Unknownserver | | 1 Bourns | CR0402-FX-1211GLF | VolumeProduction | Mouser | 652-CR0402FX-1211GLF | 0.1 | 0.1
CRCW060348R7FKEA | RESThickFilm, 48.7Ω, 1%, 0.1W, 100ppm/°C, 0603 | R11, R12, R13, R14, R15, R16, R17, R18, R19, R20, R23, R24, R25, R26, R30, R31, R33, R34 | Unknownserver | 18 Vishay | | CRCW060348R7FKEA | VolumeProduction | Digikey | 541-48.7HCT-ND | 0.026 | 0.468

RT1206DRE07100KL | RESSMD100K OHM0.5%1/4W 1206 | R21 | Unknownserver | | 1 Yageo | RT1206DRE07100KL | VolumeProduction | Arrow Electronics | RT1206DRE07100KL | 0.016 | 0.016

KTR18EZPF1501 | ResThickFilm 12061.5kΩ1% 0.1W ±100ppm/°C Automotive PaperT/R | R22 | Unknownserver | | 1 Rohm | KTR18EZPF1501 | VolumeProduction | Digikey | RHM1.50KAICT-ND | 0.21 | 0.21

RC0603FR-072K2L | ThickFilm Resistor, 2.2 KOhm, 100mW, 50V, +/- 1%, -55 to155degC, 2-PinSMD(0603), RoHS, Tapeand Reel | R27, R28, R36 | Unknownserver | | 3 Yageo | RC0603FR-072K2L | VolumeProduction | Avnet | 75X0144 | 0.011 | 0.11

CRCW06034K87FKEAHP | RESThickFilm, 4.87kΩ, 1%, 0.33W, 100ppm/°C, 0603 | R29 | Unknownserver | | 1 VishayDale | CRCW06034K87FKEAHP | VolumeProduction | Digikey | 541-CRCW06034K87FKEAHPC T-ND | 0.15 | 0.15

CRCW0603750RJNEA | | R32, R35 | Unknownserver | | 2 VishayDale | CRCW0603750RJNEA | VolumeProduction | Newark | 51P0331 | 0.003 | 0.006
RC0805JR-100RL | ChipResistor, 0 Ohm, +/- 5%, 125mW, -55to 155degC, 0805 (2012Metric), RoHS, Tapeand Reel | R38, R39, R40, R41, R42, R43, R44, R45, R46, R47, R48, R49, R50, R51, R52, R60A, R60B, R60C, R69D, R70A, R70B, R70E, R70G, R71C, R71F | Unknownserver | 25 Yageo | | RC0805JR-100RL | VolumeProduction | Arrow Electronics | RC0805JR-100RL | 0.0129 | 0.3225

RK73H2BTTD4702F | | R53, R54, R55, R56, R57 | Unknownserver | | 5 KOASpeer | RK73H2BTTD4702F | VolumeProduction | Arrow Electronics | RK73H2BTTD4702F | 0.0136 | 0.136

CRCW080520K0JNEB | RESThickFilm, 20kΩ, 5%, 0.125W, 200ppm/°C, 0805 | R58 | Unknownserver | | 1 VishayDale | CRCW080520K0JNEB | Obsolete | Mouser | 71-CRCW080520K0JNEB | 0.1 | 0.1

PTN0603E8002BST1 | RES80KOHM 0.1%0.15W 0603 | R61A, R61B, R61C | Unknownserver | | 3 VishayDale | PTN0603E8002BST1 | VolumeProduction | Mouser | 71-PTN0603E8002BST1 | 0.83 | 2.49

ERJ-PB6B3002V | Resistor | R65A, R65B | Not managed | | 2
CR0603-JW-164ELF | ThickFilmChip Resistors0603 160kΩ0.1W5% 200ppm/°C | R66C | Unknownserver | | 1 Bourns | CR0603-JW-164ELF | VolumeProduction | Mouser | 652-CR0603JW-164ELF | 0.1 | 0.1

PTS645SM43SMTR92LFS | SWITCHTACTILE SPST-NO0.05A 12V | SW1 | Unknownserver | | 1 ITTC&K | PTS645SM43SMTR92LFS | VolumeProduction | Newark | 95W3587 | 0.183 | 0.183

CHS-01TA | SWITCHSLIDE DIPSPST100MA 6V | SW2, SW3 | Unknownserver | | 2 Nidec Copal | CHS-01TA | VolumeProduction | Mouser | 229-CHS-01TA | 1.06 | 2.12

5010 | Test Point, Red, ThroughHole, RoHS, Bulk | TP1 | Unknownserver | | 1 Keystone Electronics | 5010 | VolumeProduction | Future Electronics | 9766767 | 0.285 | 0.285

5012 | Test Point, White, Through Hole, RoHS, Bulk | TP2, TP3, TP5, TP6, TP7, TP8, TP9, TP10, TP11, TP12, TP13, TP14 | Unknownserver | 12 Keystone | Electronics | 5012 | VolumeProduction | Future Electronics | 6434195 | 0.31 | 3.72

5011 | Test Point, Black, Through Hole, RoHS, Bulk | TP4 | Unknownserver | | 1 Keystone Electronics | 5011 | VolumeProduction | Future Electronics | 5322706 | 0.169 | 0.169

UA78M33CKVURG3 | ICREGLINEAR 3.3V500MA TO252-3 | U1 | Unknownserver | | 1 TexasInstruments | UA78M33CKVURG3 | VolumeProduction | Newark | 80K3502 | 0.198 | 0.198

UA78M05CKVURG3 | ICREGLINEAR 5V500MA TO252-3 | U2 | Unknownserver | | 1

STM32F417VGT6TR | RISC Microcontroller, 32-Bit, FLASH, CORTEX-M4 CPU, 168MHz, CMOS, PQFP100 | U3 | Not managed | | 1 STMicroelectronics | STM32F417VGT6TR | VolumeProduction | Mouser | 511-STM32F417VGT6TR | 15.23 | 15.23

SN65HVD234D | 3.3VCAN Transceiver with SleepMode, 6 mA, -40to125 degC, 8-pin SOIC(D), Green (RoHS&no Sb/Br) | U4 | Unknownserver | | 1 TexasInstruments | SN65HVD234D | VolumeProduction | Mouser | 595-SN65HVD234D | 4.3 | 4.3

H2019FNL | Telecom Transformer, 100BASE-TX, 0 to70degC, 16-PinSMD, RoHS | U5 | Unknownserver | | 1 Pulse | H2019FNL | Not Recommendedfor New Design | Mouser | 673-H2019FNL | 7.77 | 7.77

ABM3-8.000MHZ-D2Y-T | Crystal 8MHz ±20ppm18pF SMD-25mmx 3.2mm | Y1 | Unknownserver | | 1 Abracon | ABM3-8.000MHZ-D2Y-T | VolumeProduction | Newark | 77R1485 | 0.466 | 0.466

ASE-25.000MHZ-LC-T | XTALOscillator 25MHz±50ppm CMOS3.3V4-SMD3.2mmx 2.5mm | Y2 | Unknownserver | | 1 Abracon | ASE-25.000MHZ-LC-T | VolumeProduction | Newark | 84R2104 | 1.1 | 1.1
