Justin-Vuong/2024_WSB/(list of files, drawings)

Other design files:
2024_WSB.PrjPcb
CAN.SchDoc
Ethernet.SchDoc
MainConnector.SchDoc
MicroSD.SchDoc
Oscillator.SchDoc
Power.SchDoc
Processor.SchDoc
Programming.SchDoc
SensorInput.SchDoc
SensorPower.SchDoc
WSB.SchDoc
