Justin-Vuong/2024_WSB/(commit log)

2024-03-11 schematics WIP
    [2024_TCU.GBL, 2024_TCU.GBO, 2024_TCU.GBP, 2024_TCU.GBS, 2024_TCU.GTL, 2024_TCU.GTO, 2024_TCU.GTP, 2024_TCU.GTS]
2024-03-12 Schematics Done
    [2024_WSB.PrjPcb, CAN.SchDoc, Ethernet.SchDoc, IMU.SchDoc, MainConnector.SchDoc, MicroSD.SchDoc, Oscillator.SchDoc, Power.SchDoc]
2024-03-12 Linked Components, Starting Routing
    [2024_WSB.PrjPcb, Ethernet.SchDoc, MainConnector.SchDoc, MicroSD.SchDoc, SensorInput.SchDoc, SensorPower.SchDoc]
2024-03-12 first pass routing
    [2024_TCU.GBL, 2024_TCU.GBO, 2024_TCU.GBP, 2024_TCU.GBS, 2024_TCU.GTL, 2024_TCU.GTO, 2024_TCU.GTP, 2024_TCU.GTS]
2024-03-13 Routing Minus Connector Done. Need to Fix GND Issue
    [2024_WSB.PrjPcb, MainConnector.SchDoc, SensorInput.SchDoc, SensorPower.SchDoc, SensorPwr.SchDoc]
2024-03-14 Fix GND issue
    [2024_WSB.PrjPcb, CAN.SchDoc, Ethernet.SchDoc, MainConnector.SchDoc, MicroSD.SchDoc, Oscillator.SchDoc, Power.SchDoc, Processor.SchDoc]
2024-03-15 Cleaned up layout and silkscreen
    [2024_WSB.GBL, 2024_WSB.GBO, 2024_WSB.GBP, 2024_WSB.GBS, 2024_WSB.GTL, 2024_WSB.GTO, 2024_WSB.GTP, 2024_WSB.GTS]
2024-03-15 Added PDF
    [2024_WSB.PrjPcb, MainConnector.SchDoc, SensorPower.SchDoc, WSB.SchDoc]
2024-03-15 Added missed sensor input DNP
    [2024_WSB.PrjPcb, SensorInput.SchDoc]
2024-03-20 Change 5V Regulator to support powering Dash
    [2024_WSB.PrjPcb, Power.SchDoc]
